ND-HowardGroup/pcr/README.md

ndPCR
=====

Historical code for ND PCR thermocycler, along with most current generation.
