ND-HowardGroup/pcr/doc/ND PCR - Device Documentation.docx

ND PCR – Device Documentation

Frank Kuhny

Howard Research Group

University of Notre Dame

Summer 2013

Overview

ND PCR is a device made by students in the Howard Research Group in the Electrical Engineering department at the University of Notre Dame. The goal of this device is to provide a field-portable means of amplifying DNA for any of a number of applications including testing for invasive species of aquatic animals in the Great Lakes waterways. The following report documents the current state of both the hardware and software that is being used to run ND PCR. It is intended as a reference to anyone who intends to begin work with any part of the device. The code referred to in Section 1 can be found in Appendix A of this document, and the schematics referred to in section two can be found in Appendix B of this document.

Section 1: Code

Declaration of variables/globals:

The beginning part of the code for ND PCR declares all of the variables and globals that are used throughout the program. This part of the code takes place from line 1 to line 123. The latter parts of the code are the functions used in the code as well as the operational part of the code.

Lines 1 through 26 are introductory comments to the program stating contributors to the code. A disclaimer also states that the program itself is software for free redistribution and modification.

Line 28 of the code begins the definition of the various libraries that will be used to run the thermocycler. Of particular interest is the PID library [1]. PID stands for proportional-integral-derivative. What this library does is calculates the output power required to heat the heater to the desired temperature setpoint as quickly as possible with minimal overshoot. The other libraries are the libraries to control the various components of the device such as the keypad and the display.

The code from lines 34 to 59 defines the keypad to have four rows and three columns. This part of the code also defines an object “keypad” with the class “Keypad” from the previous library definition [2]. When keypad is called later within the program it uses the input of the row and column to define the variable “keypad” to be one of the values ‘0’-‘9’, ‘*’, or “#” based on which key is pressed on the actual keypad. Also the definition of the pins the keypad will use on the microcontroller is here. The keypad uses pins 7-13.

After this, the variables for the PCR process are defined. These are the variables that change based on the specific recipe required for the primers that are being used. The variables ‘INITIALIZATION’, ‘DENATURATION’, etc. are the variables that will be used for the temperatures for the heating block for that specific step (the same step that the name denotes). Likewise, the variables ‘INIT_TIME’, ‘DENAT_TIME’, etc. are the variables to denote the amount of time the heating block will be held at the temperature for that step before moving on to the next step.

The next set of lines is the group of function prototypes that will be used at multiple points later in the code. These will be covered more extensively at a future point. Lines 98 to 114 initialize many variables that will be used throughout various functions. The number of cycles begins at zero and is incremented each cycle.

Lines 101 and 102 define the output pins for the heater and buzzer. In the code they are defined as 3 and 5, but there is an important distinction to be made here. These pin numbers do not refer to the pins on the microcontroller itself, but rather Digital Input/Output pin number that can be found on the microcontroller’s pinout diagram. The pin number for Digital I/O 3 is pin 1, and the pin number for Digital I/O 5 is pin 9. The pin to which the buzzer is connected is pin 26 on the microcontroller, but instead of using the pin number, ‘A3’ is written for the current setup as specified by the pinout diagram [3].

The final part before the setup() function defines the ‘myPID’ variable in the PID class. This is the code’s variable for changing the temperature based on the variables input, output and setpoint variables defined in line 117. Line 122 defines the myPID variable itself with the address operator (&) to the input, output, and setpoint variables. The numerical values in line 122 are the values for Kp, Ki, and Kd, respectively, which control the rise time, overshoot, settling time, and steady-state error of the PID controller [4].

Operating Procedure:

Lines 124 through 219 comprise the operating procedure for the code. This includes the setup() and loop() functions for the code. From within these functions, all the other functions of the code are called, and those will be described later. The setup() function gets the desired recipe from the user. The loop() function within the code repeats the procedure for the desired PCR recipe by using the PID function to change the temperature of the heating block as necessary.

The setup() function begins with line 124 of the code. This function begins serial communication at the specified frequency, here 9600 baud. Also, the pins for the heater and fan are set as output pins using the pinMode() function. The setup() function also calls the recipeChoice() function to determine which recipe preset will be used when running the PCR process. Using the selected recipe, the heater then brings the heating block to the selected “INITIALIZATION” temperature and delays the program until that temperature has been reached while outputting the “WAIT FOR HEATERS” message from line 139. Lines 143 to 150 are implemented to give the user time to put the vials into the PCR device; the LCD screen is cleared and outputs the given message and waits for the user. The output message says to press 1 to start the process, but the code allows for any button to be pressed to continue with the waitforkey() command. The final part of the setup() function prints the headers to the LCD screen as well as to the Serial monitor and turns on the PID.

The next function, which begins on line 166, is the loop() function which runs the PCR thermocycler itself following setup(). The arguments of the settemperature() function are first the temperature to which the heating block will be set followed by the amount of time it will be held at that temperature. First, the heating block is brought to the initialization temperature for the given amount of time as the beginning denaturation step. Then, the “for” loop beginning in line 173 runs the thermocycling itself based on the recipe. Line 179, the denaturation step, splits the DNA into single strands; line 180 bonds the primers for the DNA onto the single strands produced in the denaturation step; line 181 binds the complementary DNA onto the single strands in the extension step. For every iteration of the process, line 176 adds one to the current value of “i” until the program has gone through the correct number of cycles as specified by the recipe.

After all the cycles have been finished, the heating block is brought to the final elongation temperature for the given time in line 188. The final hold step (refrigeration) occurs in line 190. As soon as all the steps have finished, the code displays a message on the LCD screen to remove the vials and press a key to end. During this time, the buzzer is being sounded from line 200 until any key on the keypad is pressed. Realistically, the code from lines 193 to 204, the “remove vials” message as well as the buzzer sound, should be moved just after the final elongation step in line 188 for the device as the low final hold temperature cannot usually be reached with the current setup. This way, the user can remove the vials manually and refrigerate them in with some other means. Finally, in the current code, after the key has been pressed to end the buzzer, a final message loops indefinitely saying that the run has been completed and to refrigerate the vials.

Functions:

The final section of the code for ND PCR includes the rest of the functions used within the setup() and loop() functions. These functions are employed to control the temperature of the heating block and output data to the LCD display and serial output.

Following the thermocycling loop() function is the recipeChoice() function which begins on line 221. A simple message is output to the LCD display asking the user to choose a number one through three based on what recipe they desire. Currently recipes one and two could simulate realistic PCR processes although the recipes might need to be changed for slight temperature differences or slight differences in time for a certain step based on the specifications for the primers that are being used. Recipe number three exists as a test cycle that can be run through fully within a couple minutes rather than waiting for an entire PCR process to run which takes multiple hours. This allows for testing the heating block temperature for each step, the time on each step, and the overall number of cycles that were run for one process to ensure robustness of the code. After one of the buttons has been pressed to select a recipe, a confirmation message as to which recipe has been chosen is output to the LCD display.

The settemperature() function which begins on line 312 controls the heating block to the desired temperature when called. Lines 315 and 316 use the millis() function, which determines the time in milliseconds since the current program began running. The while loop which begins running in line 320 and ends in line 337 moves the heating block from the last step’s temperature to the current step’s temperature. It also outputs to the screen every second. Once the temperature for that step has been reached within one degree Fahrenheit, the program maintains that temperature for the desired time, “settime.” This time is added to the current time of the program which gives the value of “time2” in line 341, and the temperature is held until the new time is reached; then the function ends.

When the readTemps() function is called, the board takes a 5-bit value for the analog voltage read from each of the temperature sensors on the aluminum block, from pins 22 and 23 (A7 and A0 respectively for the Analog/Digital pin values). These values represent the voltage across the sensor to ground. Lines 371 takes the sensor value and calculates the resistance of the thermistor at that time given that the thermistor is part of a voltage divider. The value of the other resistor is known to be 10k Ohms, so the value of the thermistor can be calculated based on that and the value of the voltage across the thermistor. This value is then taken and put into line 372 which is the Beta equation for calculating the temperature of a thermistor:

The value 3560 is the Beta value for the specific thermistor being used [5], and the value for r∞ is a constant based on the Beta value from the following equation:

where R0 is the resistive value of the thermistor at room temperature. The final output is in Celsius, so 273.15 is subtracted from the temperature in Kelvin. The same process is used in lines 373 and 374 to determine the temperature of the other thermistor. To simplify the results that are achieved, the two temperatures are averaged to give the subsequent temperature of the heating block.

The third to last function of the program is the printData() function. The outputs to the LCD display are the time remaining as well as the current temperature of the heating block, separated by a space. The outputs to the serial display, as can be easily seen in the code, are the current step’s desired temperature (setTemp) followed by the two temperatures of the thermistors, the “Output” from the myPID variable, and finally the time remaining on the step.

The second to last function in the code is the controltemp() function. This is called from within the settemperature() function described above. The temperature of the heating block is read in line 418 from the previous readTemps() function, and the fan is either turned on from lines 422 to 426 if the temperature is too high, or is turned off if the temperature of the heating block is too low. Line 430 changes the new input to the myPID variable to the current temperature from the readTemps() function and the next increment in temperature is computed in line 433. The corresponding output in temperature is then sent to the heater pin in line 436 using analogWrite().

The final function of the code is the calcTimeRemaining() function which returns an integer guess as to how much time in minutes is remaining for the entire PCR process. The total time for all the steps (“totTime”) is computed in line 433 by adding the initialization step time to the final elongation time, the hold time, and the number of cycles multiplied by the quantity of the denaturation step time, the annealing step time, and the extension step time. Line 446 calculates the approximated time for the heating up and cooling down between steps to be about 0.07 times the total time for all the steps. This number is added, in line 449, to the “totTime” variable to give us the approximated time for the entire process including ramp up and down times in temperature, “totalTime.” The final line returns the value of the amount of time that has passed subtracted from the total time to give us the estimated amount of time remaining until the whole process has been completed.

Section 2: Schematics

The two boards that are currently being used to run ND PCR can be broken down into eight different sections by their various purposes. These sections are as follows: power supply, microcontroller, heater and serial output, LCD interface, temperature monitoring equipment, keypad, serial to USB converter, and buzzer alert. The first six were implemented on the parent board while the last two were added to the functionality of the overall device as a result of the daughter board. Each of these sections are described and discussed in greater detail in the following segments of this document.

Power Supply:

The power supply and voltage regulator for the ND PCR is depicted in Section A of Figure 1 in Appendix B. Part J2 in this section is the connector for the input power from the battery. The 12V from the power jack connects directly to the rest of the 12V wires on the board as well as connecting to the voltage regulator; any wire connecting to a voltage source with V+ has 12V on it. The voltage regulator can be seen as part IC2 on the schematic. This is a MC7805CT voltage regulator which takes the 12V from the power jack and steps it down to 5V. A schematic for the inner workings of the MC7805CT can be found on its data sheet and involves a complex network of over 20 transistors in order to make this step down in voltage. The output of the voltage regulator connects to all wires with a VCC denotation and thus has 5V on it relative to ground.

Microcontroller:

Section B of the parent board comprises the microcontroller and support components. Pin 29 connects to the reset button on the ICSP (in-circuit serial programmer) for when the chip needs to be reset when being programmed. Pins 4, 6, and 18 connect to the 5V from the voltage regulator to power the chip; pins 3, 5, and 21 connect to the ground pins on the chip. Across pins 7 and 8 is a 16 MHz crystal oscillator which is required for the clock of the microcontroller.

The microcontroller that is used is the ATMEGA328P with TQFP package.

Heater and Serial Output:

The connector pins denoted by JP5 in Section C of the parent board are for serial output communications. Also in this section are the two thermistors that are being used to heat the current heating block. They are NTC2K radial leaded thermistors. As stated in Section 1, they are connected into a voltage divider setup, and the voltage across each of them is read as a 5-bit value into the microcontroller to determine their temperatures to be heated or cooled appropriately. Finally, a battery check is in place to ensure power is coming from the battery. This connects the voltage across a 50k Ohm resistor to pin 19 on the microcontroller.

LCD Interface:

Section D of the parent board consists of a set of 12 pin headers, 5 of which connect to pins on the microcontroller. Pins 1 and 2 on the pin header are connections to 5V and ground, respectively. Pin 3 on the pin header is connected to a potentiometer. The main device that is connected to this pin header is the LCD display which uses three of the pins. A temporary buzzer is also connected to one of the pins for testing but will be implemented otherwise in the future.

Temperature Monitoring:

Section E consists of two sets of connectors to other components used in the PCR device. The JP4 connector pins are used for the heater to control the heating block. One of the pins is connected to 12V and the other is connected to the collector of the NPN transistor. This one, the TIP120, is a Darlington transistor which is a single device which has two cascaded NPN transistors sharing a common collector and with the emitter of one connected to the base of the other. The advantage of this device is that it allows for a much higher DC current gain than a single transistor could. For the TIP120, the current gain, also denoted by hFE, has a minimum value of 1000. The 500 ohm resistor connected to the base of the Darlington transistor ensures that the device operates in saturation. Similarly, JP1 is the set of connector pins to the fan. The fan is also connected on one side to the 12V power source but is instead connected to a PN2N2222A silicon transistor. This is only a single NPN transistor with minimum hFE values ranging from only 30-100. Likewise with this transistor, a resistor (this time 1K Ohm) is connected to the base to ensure the transistor operates in saturation when on. A capacitor is connected across both of these circuits, for the fan and heater controls, to provide positive feedback to them.

Keypad:

The final part of the parent board, Section F, contains the pin connectors for the keypad as well as pin connectors for the in-circuit serial programmer.

Serial to USB converter:

The daughter board consists of two sections itself. The first, Section G, is a USB to TTL serial converter. The chip that is used is the FT232RL chip. The setup and implementation for this circuit can be found on www.sparkfun.com/tutorials/108.

Buzzer alert:

Section H on the daughter board is the circuit for the buzzer as well as connector pins. The circuit for the buzzer is similar to the one for the fan on the parent board, having the pins across the buzzer connect to VCC and to the collector of the NPN transistor. This time though, a BC547 transistor is used as well as a 10k Ohm resistor going from the input pin to the base to ensure the device operates in saturation. The final set of connector pins has a pin for serial transmission, serial receiving, the buzzer input, VCC, and ground.

Section 3: Future Work

There are a few additional operations which ND PCR will hopefully be running by next summer. The first of these would be getting the serial communications to work so that data from the device can be sent to a computer. With the addition of the serial to USB converter this past summer, getting these communications running should require little, but still some, testing.

Another goal for ND PCR in the near future would be to get multiple wells working for the PCR process whereas only one well of the current heating block works successfully. There are likely two steps that need to be done so that this will work well. First the wells will likely need to be run separately instead of attempting to run three (or however man) on the same heating block. Dissipation of heat is not even across the current heating block. For multiple wells to work in the future, a more powerful microcontroller will need to be used to control separated single wells, but this will also require a redesign of the cooling/fan system in the current device.

The final goal for ND PCR in the near future is the joining of the device with the testing device used in the lab run by Dr. Hsueh-Chia Chang. With the uniting of the two devices, not only would DNA be amplified but it would also be tested for being of a specific type of animal all at once.

Appendix A

1. /* PersonalPCR, code for Arduino based PCR
2. Copyright (C) 2011 Chris Templeman <templemanautomation.com>
3. 2012 Scott Howard <showard@nd.edu>
5. Authors: Chris Templeman
6. Matt Brittan
7. Alex Toombs
8. Elizabeth Hunschke
9. Frank Kuhny
11. Date Last Modified: 5/19/13
13. This program is free software: you can redistribute it and/or modify
14. it under the terms of the GNU General Public License as published by
15. the Free Software Foundation, either version 3 of the License, or
16. (at your option) any later version.
18. This program is distributed in the hope that it will be useful,
19. but WITHOUT ANY WARRANTY; without even the implied warranty of
20. MERCHANTABILITY or FITNESS FOR A PARTICULAR PURPOSE. See the
21. GNU General Public License for more details.
23. You should have received a copy of the GNU General Public License
24. along with this program.
25. If not, see <http://www.gnu.org/licenses/>.
26. */
28. #include <PID_v1.h>
29. #include <math.h>
30. #include <SoftwareSerial.h>
31. #include <serLCD.h>
32. #include <Keypad.h>
34. //Four rows
35. const byte ROWS = 4;
36. //Three columns
37. const byte COLS = 3;
38. //Define the Keymap
39. char keys[ROWS][COLS] = {
40. {
41. '1','2','3' }
42. ,
43. {
44. '4','5','6' }
45. ,
46. {
47. '7','8','9' }
48. ,
49. {
50. '*','0','#' }
51. };
52. //connect to the row pinouts of the keypad
53. byte rowPins[ROWS] = {
54. 12, 7, 8, 10 };
55. //connect to the column pinouts of the keypad
56. byte colPins[COLS] = {
57. 11, 13, 9 };
59. Keypad keypad = Keypad( makeKeymap(keys), rowPins, colPins, ROWS, COLS );
61. // PCR Temperatures in C, to be set by recipe or user with keypad
62. // Presets set in recipeChoice function
63. double INITIALIZATION = 95;
64. double DENATURATION = 95;
65. double ANNEAL = 55;
66. double EXTENSION = 72;
67. double FINAL_ELONGATION = 72;
68. double HOLDT = 10;
70. // Number of cycles, input in recipeChoice
71. int NUMBER_OF_CYCLES = 35;
73. // PCR cycle times, corresponding to above double temps.
74. // Set in recipeChoice function.
75. double INIT_TIME = 30;
76. double DENAT_TIME = 30;
77. double ANNL_TIME = 60;
78. double EXT_TIME = 60;
79. double FIN_TIME = 300;
80. double HLD_TIME = 20;
82. // Definie the serial LCD object and communication pin
83. const int pin = 19;
84. serLCD lcd(pin);
86. // core function protoypes
87. // Directs user to select a recipe
88. void recipeChoice();
89. // Calls controltemp() to bring temp to a new level, hold it for a set time, calls printData() to display what is happening
90. void settemperature(double settemp, long settime);
91. // Prints data to LCD screen and serial monitor (time remaining in minutes, current temp)
92. void printData(double setTemp, int timer);
93. // Reads voltages from thermistor/resistor voltage dividers and calculates temperatures
94. void readTemps();
95. // Uses PID control with measurements from readTemps to set power to heater and fan
96. void controltemp(boolean fan_on, unsigned long timerinit, unsigned long timer, double settemp);
98. // track number of cycles
99. int cycle = 0; //"global" because used by serial print
101. // heater, fan, and buzzer pins
102. const int heater = 3;
103. const int fan = 5;
104. const int buzzer = A3;
106. // temperature for heater 1
107. double temp1 = 0;
108. // temperature for heater 2
109. double temp2 = 0;
110. // averaged temps
111. double temp = 0;
113. // will output every one sec
114. unsigned long pulse=0;
116. // Define PID variables we'll be connecting to
117. double Setpoint, Input, Output;
119. //Specify the links and initial tuning parameters, also do so in
120. //loop() with SetTunings
121. // tunings are setup and material specific
122. PID myPID(&Input, &Output, &Setpoint,33.01,0.35,120.55, DIRECT);
124. // Set up variables, recipe choice, and headers
125. void setup()
126. {
127. // Begin serial communication at 9600 baud
128. Serial.begin(9600);
129. // set output pins to output
130. pinMode(heater, OUTPUT);
131. pinMode(fan, OUTPUT);
133. // Get recipe to control cycle
134. recipeChoice();
136. // print delay message until heaters are at INITIALIZATION point
137. while(temp > INITIALIZATION) {
138. lcd.selectLine(1);
139. lcd.print("WAIT FOR HEATERS");
140. }
142. // after heats are heated, wait for input before starting recipe
143. lcd.clear();
144. lcd.selectLine(1);
145. lcd.print("Load vials");
146. lcd.selectLine(2);
147. lcd.print("Hit 1 to start");
149. // wait until any key is pressed.
150. keypad.waitForKey();
152. // Print headers on LCD
153. lcd.clear();
154. lcd.print("min_left T");
155. lcd.selectLine(2);
157. // Print to Serial Monitor on Laptop
158. Serial.print(" s cyc sp T1 T2 output time_rem");
160. //turn the PID on
161. myPID.SetMode(AUTOMATIC);
163. }
165. // Doesn't actually loop like it's supposed to. This will only loop once, in theory
166. void loop()
167. {
168. // Set the temperature to remain at INITIALIZATION for INIT_TIME seconds
169. settemperature(INITIALIZATION, INIT_TIME);
171. // Loop for PCR recipe while current cycles is less than total number of cycles, as specified in recipe
172. // Real loop is here!
173. for (int i = 0; i < NUMBER_OF_CYCLES; i++)
174. {
175. // increment cycle
176. cycle++;
178. // step through each step of process
179. settemperature(DENATURATION, DENAT_TIME);
180. settemperature(ANNEAL, ANNL_TIME);
181. settemperature(EXTENSION, EXT_TIME);
182. }
183. cycle++;
185. // PCR process loop ended; elongating, holding, then buzzing
187. // Final
188. settemperature(FINAL_ELONGATION, FIN_TIME);
189. // Hold at HOLD_TEMPERATURE for a long time
190. settemperature(HOLDT, HLD_TIME);
192. // Play buzzer until button hit, as PCR is done, tubes should be removed
193. lcd.clear();
194. lcd.selectLine(1);
195. lcd.print("REMOVE VIALS!");
196. lcd.selectLine(2);
197. lcd.print("Hit Key For End");
199. // play annoying buzzer until they hit a key to alert for vial removal
200. digitalWrite(buzzer, HIGH);
202. // buzzer should play until a key is pressed
203. keypad.waitForKey();
204. digitalWrite(buzzer, LOW);
206. lcd.clear();
208. // display end message, loop infinitely
209. while(1) {
210. lcd.selectLine(1);
211. lcd.print("Fridge vials!");
212. lcd.selectLine(2);
213. lcd.print("Run complete.");
215. // delay to prevent flicker
216. delay(500);
217. }
218. }
220. // Either choose a preset recipe for temperatures
221. void recipeChoice() {
222. // Clear LCD, select line 1
223. lcd.clear();
224. lcd.selectLine(1);
226. // Welcome message displayed
227. delay(1000);
228. lcd.print("Welcome to NDPCR");
229. delay(2000);
230. lcd.clear();
231. lcd.clear();
233. lcd.selectLine(1);
234. lcd.print("Enter choice:");
235. lcd.selectLine(2);
236. lcd.print("(1 thru 3)");
238. // Recipe choice input (char digit)
239. char c2 = keypad.waitForKey();
241. // Sets recipes, can be 0-9, # and * as chars (up to 12 recipes stored)
242. if(c2 == '1') {
243. // Edit these fields to change recipe
244. INITIALIZATION = 95;
245. DENATURATION = 95;
246. ANNEAL = 55;
247. EXTENSION = 72;
248. FINAL_ELONGATION = 72;
249. HOLDT = 10;
250. NUMBER_OF_CYCLES = 35;
252. // Change timing, set in seconds
253. INIT_TIME = 30;
254. DENAT_TIME = 30;
255. ANNL_TIME = 60;
256. EXT_TIME = 60;
257. FIN_TIME = 300;
258. HLD_TIME = 20;
260. lcd.clear();
261. lcd.print("Rcp 1 Chosen");
262. delay(500);
263. }
264. else if(c2 == '2') {
265. // Edit these fields to change recipe
266. INITIALIZATION = 90;
267. DENATURATION = 96;
268. ANNEAL = 50;
269. EXTENSION = 74;
270. FINAL_ELONGATION = 73;
271. HOLDT = 12;
272. NUMBER_OF_CYCLES = 20;
274. // Change timing, set in seconds
275. INIT_TIME = 30;
276. DENAT_TIME = 30;
277. ANNL_TIME = 60;
278. EXT_TIME = 60;
279. FIN_TIME = 300;
280. HLD_TIME = 20;
282. lcd.clear();
283. lcd.print("Rcp 2 Chosen");
284. delay(500);
285. }
286. else if(c2 == '3') {
287. // Edit these fields to change recipe
288. // This recipe currently used to test lcd display
289. INITIALIZATION = 35;
290. DENATURATION = 30;
291. ANNEAL = 25;
292. EXTENSION = 27;
293. FINAL_ELONGATION = 27;
294. HOLDT = 23;
295. NUMBER_OF_CYCLES = 3;
297. // Change timing, set in seconds
298. INIT_TIME = 10;
299. DENAT_TIME = 10;
300. ANNL_TIME = 10;
301. EXT_TIME = 5;
302. FIN_TIME = 5;
303. HLD_TIME = 5;
305. lcd.clear();
306. lcd.print("Test RCP!");
307. delay(500);
308. }
309. }
311. // Set temperature of heaters
312. void settemperature(double settemp, long settime)
313. {
314. unsigned long timer, time2, timerinit;
315. timer = millis();
316. timerinit=timer;
317. Setpoint = settemp;
319. // while temperature is off from settemp, keep looping
320. while (abs(temp-settemp) > 1.0)
321. {
322. // control PID and fan with other function
323. controltemp(1, timerinit, timer, settemp);
325. // get current time in ms
326. timer=millis();
328. // print to screen every second
329. if(timer>pulse)
330. {
331. // increment by 1 second
332. pulse+=1000;
334. // output to screen
335. printData(settemp, 0);
336. }
337. }
339. // Grabs time to control step duration
340. timerinit=timer;
341. time2=settime*1000+timerinit;
343. // Hold at temperature while at current step
344. while (timer < time2)
345. {
346. // control PID output and fan on/off by using controltemp function
347. controltemp(1, timerinit, timer, settemp);
349. // Every second, output to screen
350. timer=millis();
351. if(timer>pulse)
352. {
353. pulse+=1000;
354. // print data to LCD/serial monitor
355. printData(settemp, (timer-timerinit)/1000.0);
356. }
357. }
358. }
360. // read temperatures from digital temperature sensors on aluminum block
361. void readTemps()
362. {
363. double r1, r2;
364. int sensorValue1, sensorValue2;
365. //read all three sensors
366. sensorValue1 = analogRead(A0);
367. delay(1); //delay to prevent excess ringing, from datasheet
368. sensorValue2 = analogRead(A7);
370. //convert all thermistors from "counts" voltage to C
371. r1 = 1000.0/((1023.0/sensorValue1) - 1);
372. temp1 = 3560.0/log(r1/0.0130444106) - 273.15;
373. r2 = 1000.0/((1023.0/sensorValue2) - 1);
374. temp2 = 3560.0/log(r2/0.0130444106) - 273.15;
376. // Average temperatures of two sensors to control fan and PID
377. temp = (temp1 + temp2) / 2;
378. }
381. // displays data to LCD monitor and serial monitor
382. void printData(double setTemp, int timer)
383. {
384. char buff[17];
386. // buffered charString that contains data printed to LCD
387. sprintf(buff, "%3.d ", calcTimeRemaining());
389. // Prints out time remaining in minutes and current averaged temp (always on line 2)
390. lcd.selectLine(2);
391. lcd.print(buff);
392. lcd.print(" ");
393. lcd.print(temp);
395. // Print to serial monitor as well
396. // Appearance: ## ##.## ##.## ##.##
397. Serial.println();
398. Serial.println();
399. Serial.print(buff);
400. Serial.print(" ");
401. Serial.print(int(setTemp));
403. Serial.print(" ");
405. Serial.print(temp1);
406. Serial.print(" ");
407. Serial.print(temp2);
408. Serial.print(" ");
409. Serial.print(Output);
410. Serial.print(" ");
411. Serial.print(calcTimeRemaining());
412. }
414. // Control temperature by calculating PID and turning fan on or off.
415. void controltemp(boolean fan_on, unsigned long timerinit, unsigned long timer, double settemp)
416. {
417. // Read temperatures into global variables
418. readTemps();
420. // if temp too high, turn fan on to cool. else, turn fan off.
421. // NOTE: fan_on is a stupid variable that is always 1 when this function is called
422. if (fan_on && temp>settemp+1)
423. {
424. // turn fan on
425. digitalWrite(fan, HIGH);
426. }
427. else digitalWrite(fan, LOW);
429. // Send temperature to PID controller for predictive contrl
430. Input = temp;
432. // Compute next PID step
433. myPID.Compute();
435. // Control heater based upon PID compute
436. analogWrite(heater, Output);
437. }
439. // return time remaining on this PCR recipe
440. // return: time remaining in minutes, int
441. int calcTimeRemaining() {
442. // total process time in seconds, excluding ramp times
443. int totTime = INIT_TIME + (NUMBER_OF_CYCLES * (DENAT_TIME + ANNL_TIME + EXT_TIME)) + (FIN_TIME + HLD_TIME);
445. // "fudge factor" for ramp times, etc.; needs to be more elegant later
446. int fudgeFactor = totTime*.07;
448. // Calculate final time
449. int totalTime = totTime + fudgeFactor;
451. // returns time remaining in minutes as an integer
452. return (totalTime - (millis()/1000))/60;
453. }

Appendix B

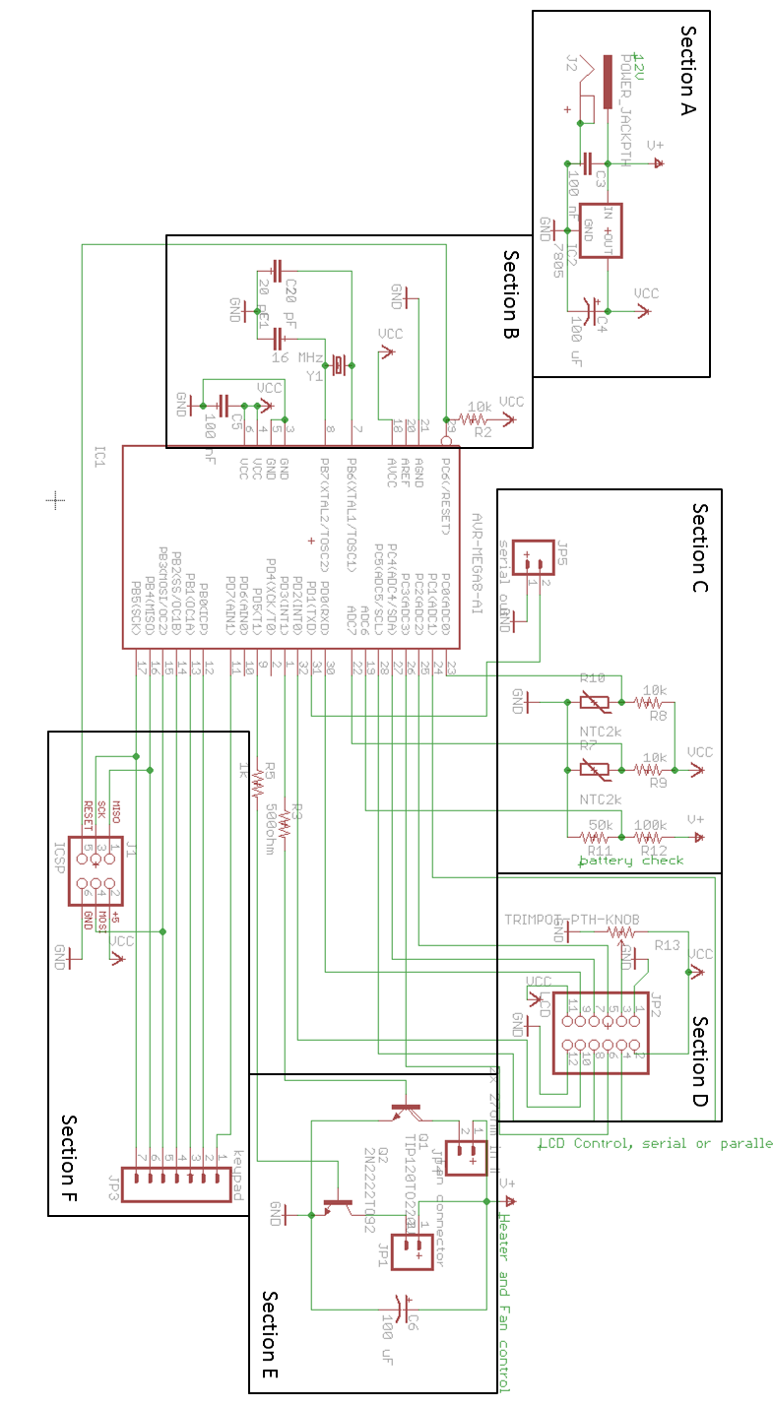
[picture p1: figure]

Figure 1. Schematic for Parent Board

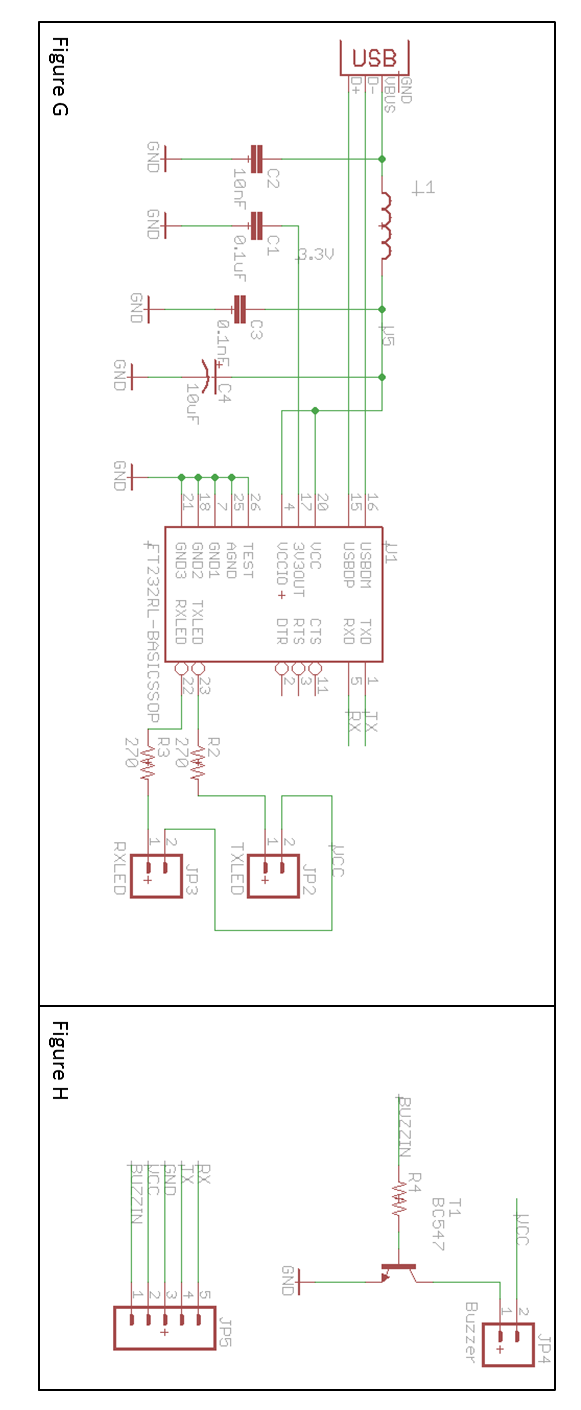
[picture p2: figure]

Figure 2. Schematic for Daughter Board

Works Cited

[1] https://github.com/br3ttb/Arduino-PID-Library/blob/master/PID_v1/PID_v1.h

[2] http://playground.arduino.cc/Code/Keypad#CurrentVersion

[3] http://www.hobbytronics.co.uk/arduino-atmega328-pinout

[4] http://wwwdsa.uqac.ca/~rbeguena/Systemes_Asservis/PID.pdf

[5] http://www.epcos.com/inf/50/db/ntc_09/MiniSensors__B57861__S861.pdf
