ND-HowardGroup/pcr/doc/PCR_basics.pdf

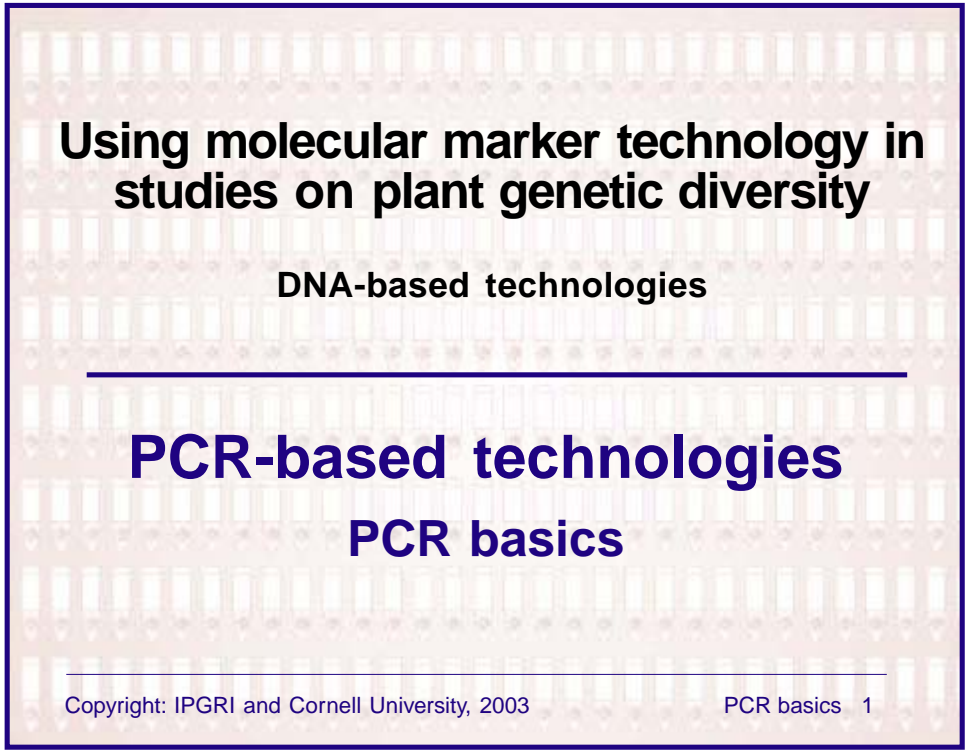
[picture p3: figure]
Using molecular marker technology in studies on plant genetic diversity; DNA-based technologies; PCR-based technologies PCR basics

Copyright: IPGRI and Cornell University, 2003 | PCR basics 1

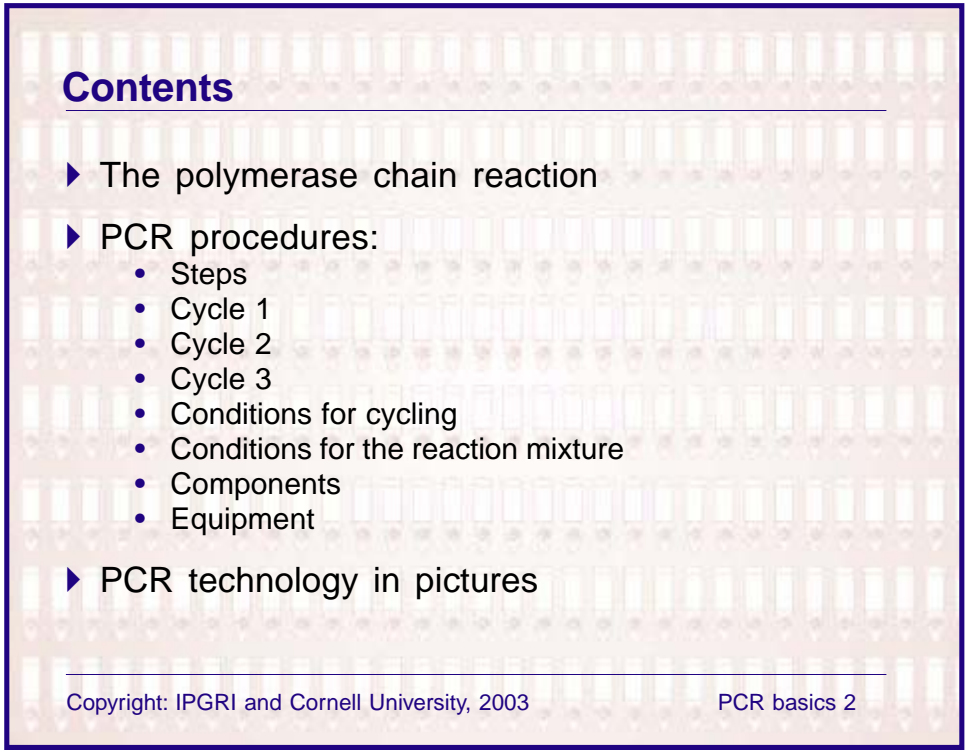
[picture p4: figure]
Contents; ! The polymerase chain reaction; ! PCR procedures: • Steps; • Cycle 1 • Cycle 2 • Cycle 3 • Conditions for cycling • Conditions for the reaction mixture • Components • Equipment ! PCR technology in pictures

2

Copyright: IPGRI and Cornell University, 2003 | PCR basics 2

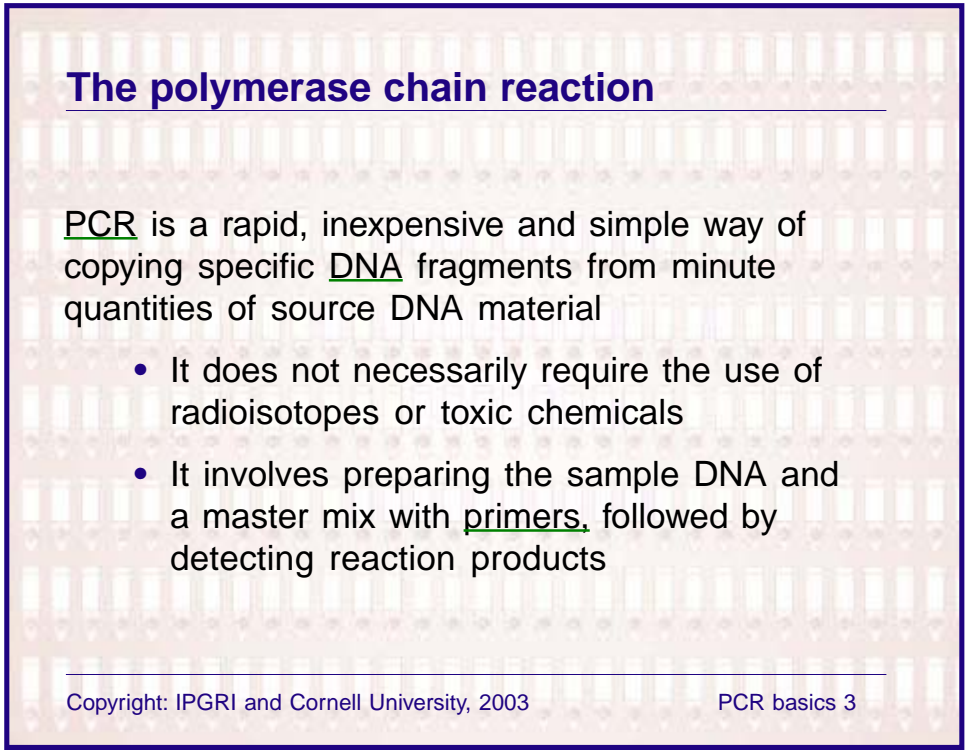
[picture p5: figure]
quantities of source DNA material; radioisotopes or toxic chemicals; a master mix with primers, followed by detecting reaction products; The polymerase chain reaction

3

Copyright: IPGRI and Cornell University, 2003 | PCR basics 3

## PCR is a rapid, inexpensive and simple way of copying specific DNA fragments from minute

## - It does not necessarily require the use of

## - It involves preparing the sample DNA and

The polymerase chain reaction (PCR; Erlich, 1989) is a powerful technique that has rapidly become one of the most widely used techniques in molecular biology because it is quick, inexpensive and simple. The technique amplifies specific DNA fragments from minute quantities of source DNA material, even when that source DNA is of relatively poor quality.

Reference

Erlich, H.A. 1989. PCR technology: principles and applications for DNA amplifications. Stockton Press, NY.

4

Copyright: IPGRI and Cornell University, 2003 | PCR basics 4

## PCR procedures: steps

The DNA polymerase, known as 'Taq polymerase', is named after the hot-spring bacterium Thermus aquaticus from which it was originally isolated. The enzyme can withstand the high temperatures needed for DNA-strand separation, and can be left in the reaction tube.

The cycle of heating and cooling is repeated over and over, stimulating the primers to bind to the original sequences and to newly synthesised sequences. The enzyme will again extend primer sequences. This cycling of temperatures results in copying and then copying of copies, and so on, leading to an exponential increase in the number of copies of specific sequences. Because the amount of DNA placed in the tube at the beginning is very small, almost all the DNA at the end of the reaction cycles is copied sequences.

The reaction products are separated by gel electrophoresis. Depending on the quantity produced and the size of the amplified fragment, the reaction products can be visualised directly by staining with ethidium bromide or a silver-staining protocol, or by means of radioisotopes and autoradiography.

## ! Denaturation: DNA fragments are heated at high temperatures, which reduce the DNA double helix to single strands. These strands become accessible to primers

! Annealing: The reaction mixture is cooled down.

## Primers anneal to the complementary regions in the DNA template strands, and double strands are formed again between primers and complementary sequences

## ! Extension: The DNA polymerase synthesises a complementary strand. The enzyme reads the opposing strand sequence and extends the primers by adding nucleotides in the order in which they can pair. The whole process is repeated over and over

5

Copyright: IPGRI and Cornell University, 2003 | PCR basics 5

## PCR procedures: cycle 1

The PCR steps are all carried out, one after the other, in bouts of cycling. Cycle 1 is as follows:

- During denaturation (about 1 min at 95°C), the DNA strands separate to form single strands.
- During annealing (about 1 min at temperatures ranging between 45°C and 60°C), one primer binds to one DNA strand and another binds to the complementary strand. The annealing sites of the primers are chosen so that they will prime DNA synthesis in the region of interest during extension.
- During extension (about 1 min at 72°C), the DNA synthesis proceeds through the target region and for variable distances into the flanking region, giving rise to 'long fragments' of variable lengths

Double-stranded template DNA

5´ | 3´
3´ | 5´

Denaturing

Annealing

Extension

Primer 2 | Primer 1
5´ | 3´
5´ | 3´
3´ | 5´
3´ | 5´
3´ | 5´
5´ | 3´ Primer recognition site

Primer
recognition site

Adapted from Griffiths et al. 1996

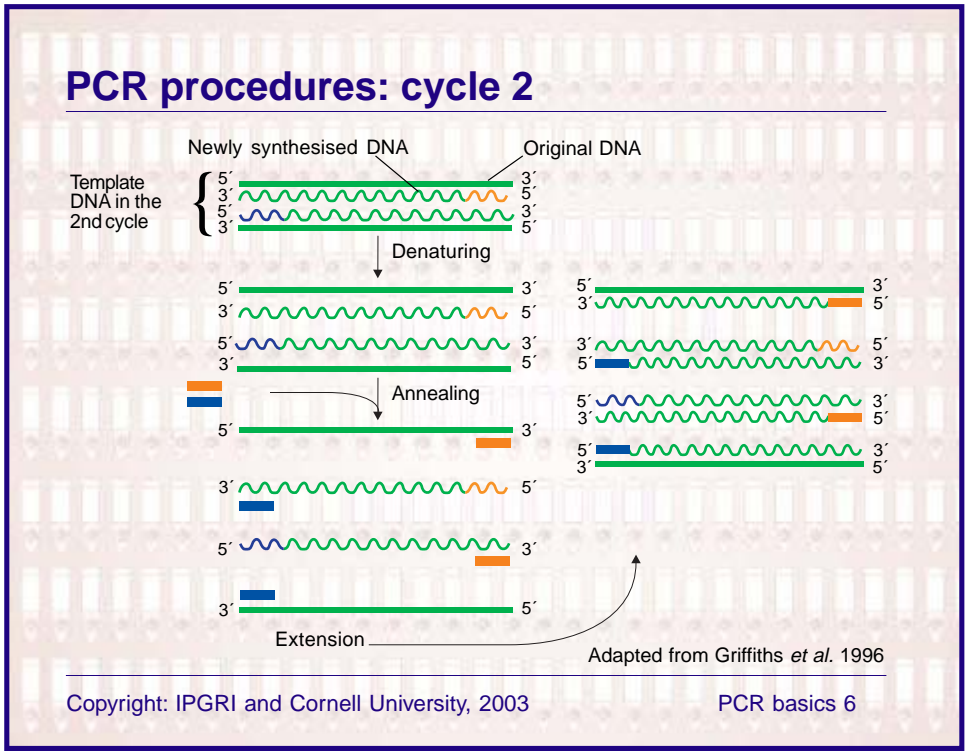
[picture p6: figure]
PCR procedures: cycle 2; Adapted from Griffiths et al. 1996; Denaturing; Annealing; Extension; Newly synthesised DNA; Template DNA in the 2nd cycle; Original DNA

6

Copyright: IPGRI and Cornell University, 2003 | PCR basics 6

When the second cycle starts, there are effectively two types of template: (1) the original DNA strands; and (2) the newly synthesised DNA strands, consisting of the target region and variable lengths of the flanking region at the 3' end. When the latter template is used in this cycle, only the target region is replicated.

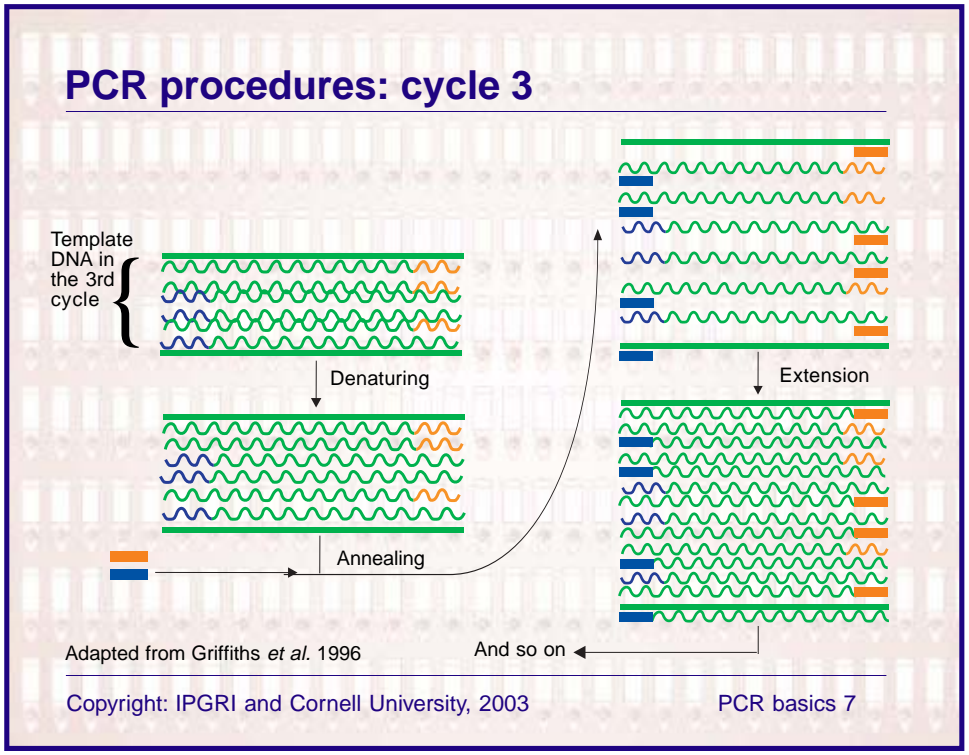
[picture p7: figure]
PCR procedures: cycle 3; Template DNA in the 3rd cycle; And so on; Denaturing; Annealing; Extension; Adapted from Griffiths et al. 1996

7

Copyright: IPGRI and Cornell University, 2003 | PCR basics 7

In the third cycle, the newly synthesised target region DNA (i.e. without flanking regions) acts as template. The original DNA molecule is still present, and will be until the end of the reaction. However, after a few cycles, the newly synthesised DNA fragment quickly establishes itself as the predominant template.

Cycles are typically repeated 25 to 45 times. Standardisation of the thermocycler's running conditions is essential for the reproducibility of results.

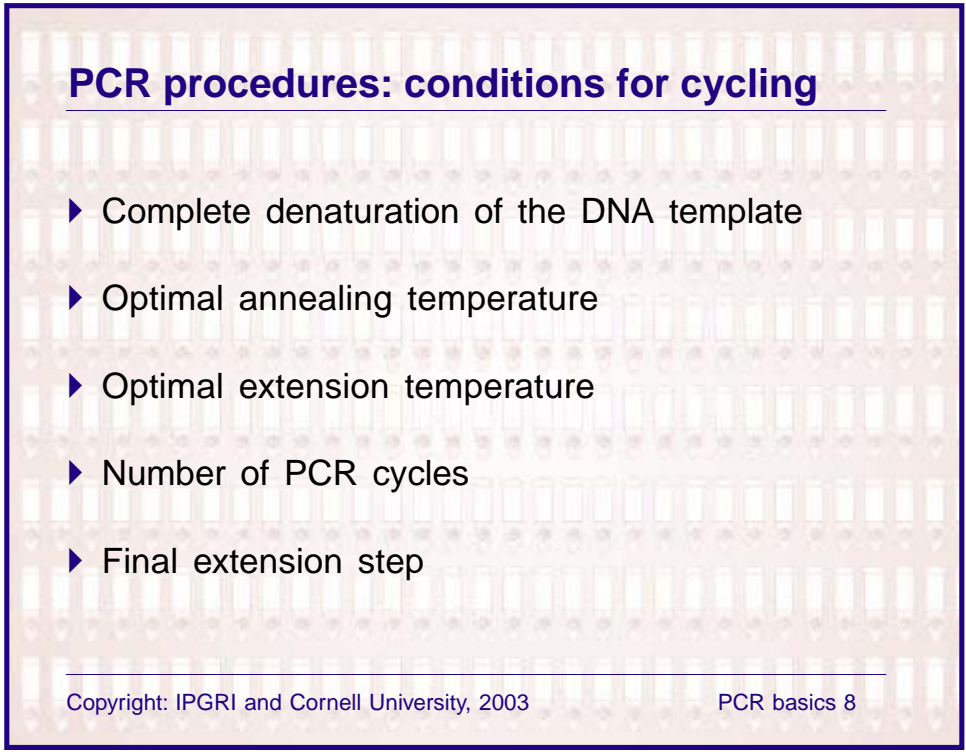
[picture p8: figure]
PCR procedures: conditions for cycling; ! Optimal annealing temperature; ! Optimal extension temperature; ! Number of PCR cycles; ! Final extension step

8

Copyright: IPGRI and Cornell University, 2003 | PCR basics 8

## ! Complete denaturation of the DNA template

In the initial denaturation step, complete denaturation of the DNA template at the start of the PCR reaction is essential. Incomplete denaturation of DNA will result in the inefficient use of the template in the first amplification cycle and, consequently, poor yield of PCR product.

The annealing temperature may be estimated as 5°C lower than the melting temperature of the primer-template DNA duplex. If non-specific PCR products are obtained in addition to the expected product, the annealing temperature can be optimised by increasing it stepwise by 1-2°C.

Usually, the extension step is performed at 72°C and a 1-min extension is sufficient to synthesise PCR fragments as long as 2 kb (kb = kilobase = 1000 bp). When larger DNA fragments are amplified, time is usually extended by 1 min per 1000 bp.

The number of PCR cycles will basically depend on the expected yield of the PCR product.

After the last cycle, samples are usually incubated at 72°C for 5 min to fill in the protruding ends of newly synthesised PCR products.

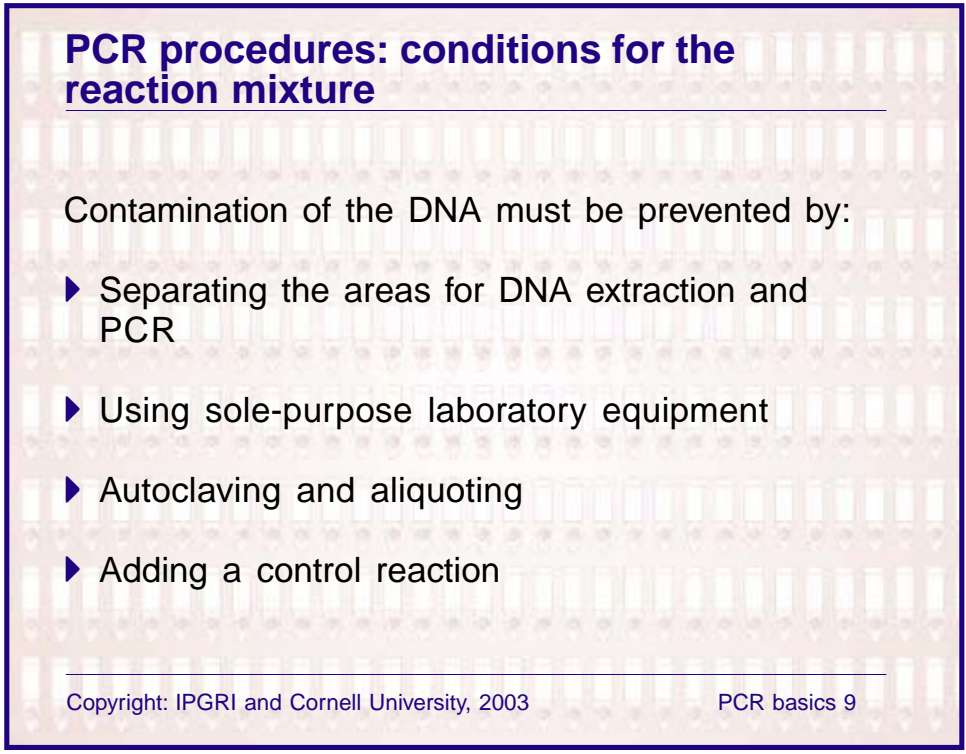
[picture p9: figure]
PCR procedures: conditions for the reaction mixture; PCR; ! Autoclaving and aliquoting; ! Adding a control reaction

9

Copyright: IPGRI and Cornell University, 2003 | PCR basics 9

## Contamination of the DNA must be prevented by:

## ! Separating the areas for DNA extraction and

## ! Using sole-purpose laboratory equipment

Some useful tips:

- DNA extraction and PCR reaction mixing and processing should be performed in separate areas.
- Use of sole-purpose vessels and positive displacement pipettes or tips for DNA sample and reaction mixture preparation is strongly recommended.
- All solutions, except dNTPs, primers and Taq DNA polymerase, should be autoclaved. Where possible, solutions should be aliquoted in small quantities and stored in designated PCR areas.
- A good practice, to confirm absence of contamination, is to add a control reaction without template DNA.

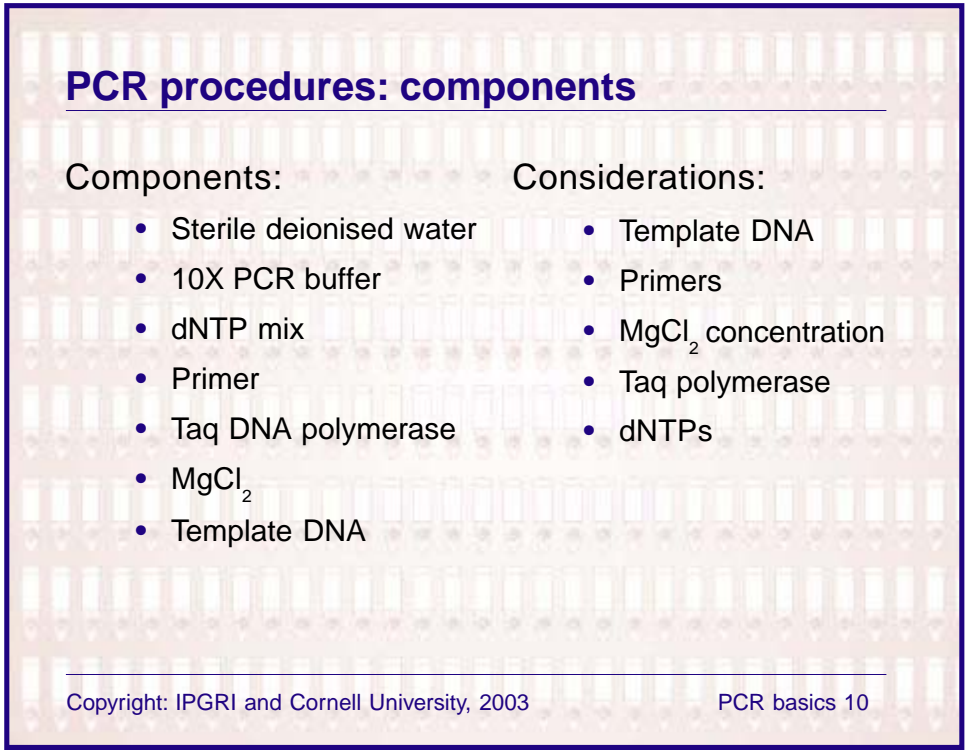
[picture p10: figure]
PCR procedures: components; Components:; • Sterile deionised water • 10X PCR buffer • dNTP mix • Primer • Taq DNA polymerase • MgCl2 • Template DNA; Considerations:; • Template DNA • Primers • MgCl2; concentration • Taq polymerase • dNTPs

10

Copyright: IPGRI and Cornell University, 2003 | PCR basics 10

Many PCR machines are now available in 48-, 96- or 384-well formats. This, combined with the use of multichannel pipettors, can greatly increase the number of reactions that can be done simultaneously. If several reactions need to be simultaneously prepared, a master mix should be used as follows: water, buffer, dNTPs, primers, MgCl2 and Taq DNA polymerase in a single tube. This will then be aliquoted into individual tubes. Considerations:

Template DNA. Nearly any standard method is suitable for template DNA purification. An adequate amount of template DNA is between 0.1 and 1 µg for genomic DNA for a total reaction mixture of 100 µl. Larger template DNA amounts usually increase the yield of non-specific PCR products.

Primers. (1) PCR primers should be 10-24 nucleotides in length. (2) The GC content should be 40%-60%. (3) The primer should not be self-complementary or complementary to any other primer in the reaction mixture, to prevent primer-dimer and hairpin formation.
(4) Melting temperatures of primer pairs should not differ by more than 5°C, so that the GC content and length must be chosen accordingly. (5) The melting and annealing temperatures of a primer are estimated as follows: if the primer is shorter than 25 nucleotides, the approximate melting temperature is calculated with the formula: Tm = 4 (G + C) + 2 (A + T). (6) The annealing temperature should be about 5°C lower than the melting temperature.
MgCl2 concentration. Because Mg2
+ ions form complexes with dNTPs, primers and DNA templates, the optimal concentration of MgCl2 has to be selected for each experiment. Too few Mg2
+ ions result in a low yield of PCR product, and too many will increase the yield of non-specific products. The recommended range of MgCl2 concentration is 1 to 3 mM, under the standard reaction conditions specified.

Taq DNA polymerase. Higher Taq DNA polymerase concentrations than needed may cause synthesis of non-specific products.

dNTPs. The concentration of each dNTP (dATP, dCTP, dGTP, dTTP) in the reaction mixture is usually 200 µM. These concentrations must be checked as being equal, because inaccuracies will increase the degree of misincorporation.

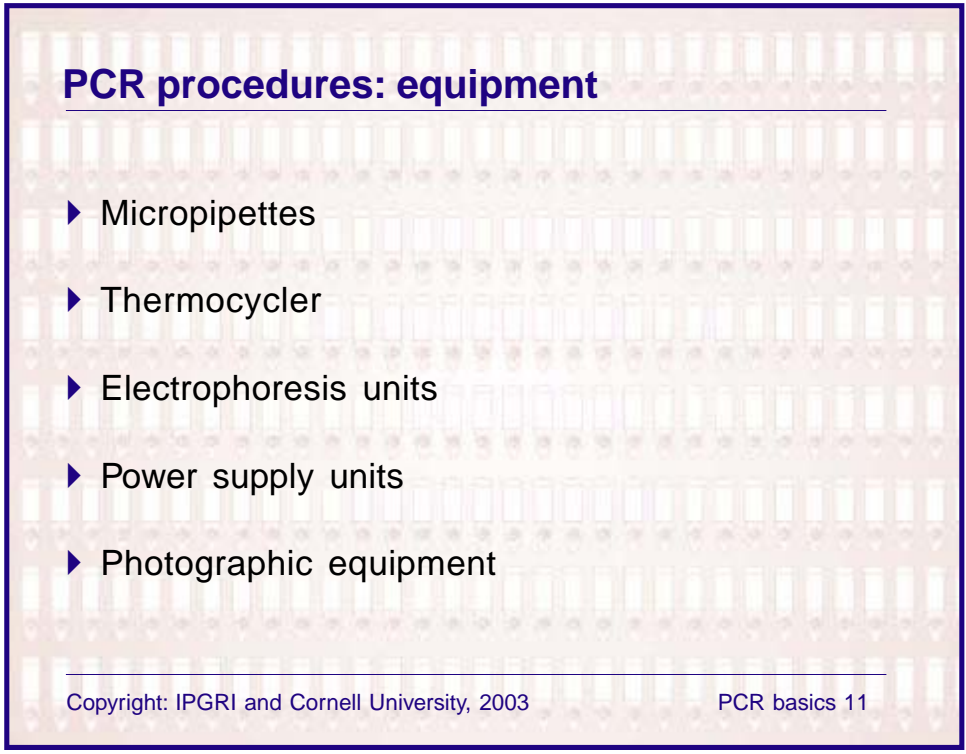
[picture p11: figure]
PCR procedures: equipment; ! Micropipettes; ! Thermocycler; ! Electrophoresis units; ! Power supply units; ! Photographic equipment

11

Copyright: IPGRI and Cornell University, 2003 | PCR basics 11

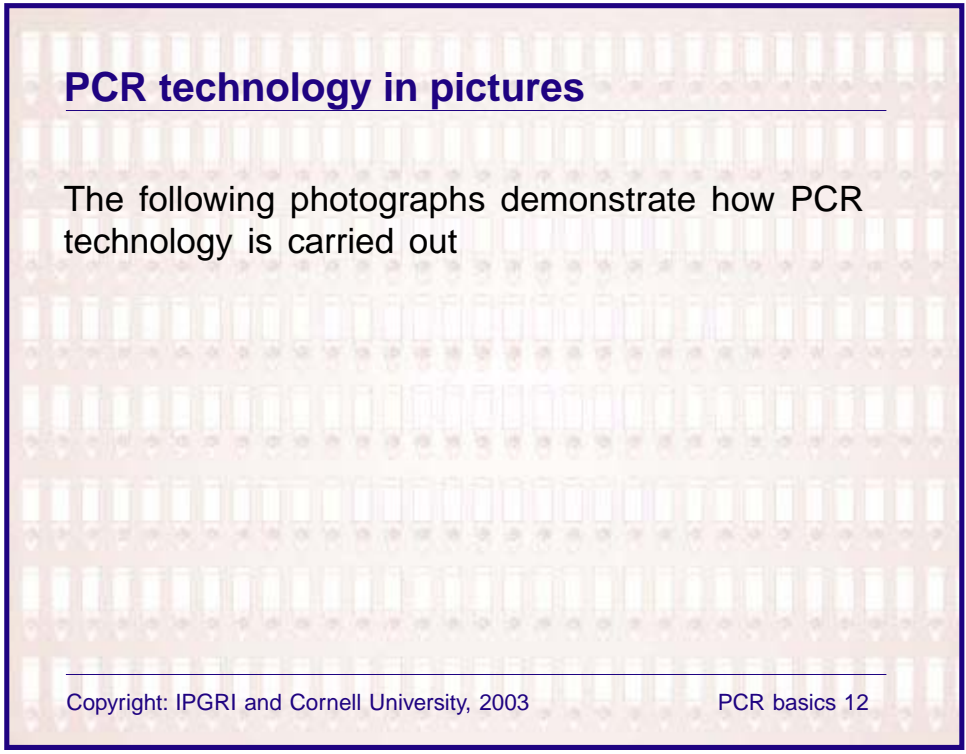
[picture p12: figure]
PCR technology in pictures; technology is carried out

12

Copyright: IPGRI and Cornell University, 2003 | PCR basics 12

## The following photographs demonstrate how PCR

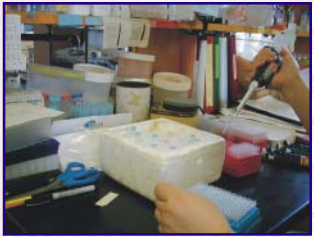
[picture p13: figure]

13

Copyright: IPGRI and Cornell University, 2003 | PCR basics 13

The PCR mixture is prepared on ice. Safety clothing is not required, but may benefit the reaction unless good sterile techniques are practised.

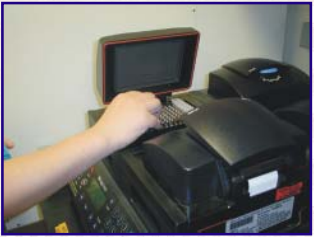
[picture p14: figure]

14

Copyright: IPGRI and Cornell University, 2003 | PCR basics 14

The PCR reactions are loaded into the thermocycler.

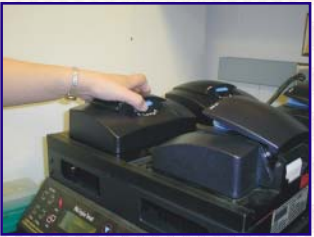
[picture p15: figure]

15

Copyright: IPGRI and Cornell University, 2003 | PCR basics 15

The thermocycler is locked shut and programmed.

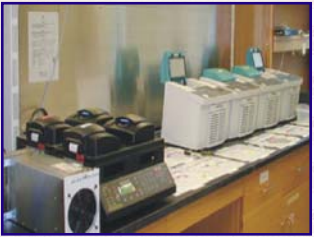
[picture p16: figure]

16

Copyright: IPGRI and Cornell University, 2003 | PCR basics 16

Different types of thermocyclers exist: the black one is a tetrad, in which 4 sets of 96 samples can be run simultaneously. The four smaller white ones each have a 96-well capacity.

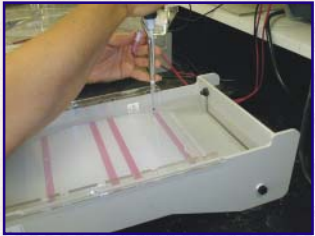
[picture p17: figure]

17

Copyright: IPGRI and Cornell University, 2003 | PCR basics 17

Depending on the size of the PCR bands produced and the discrimination needed, band visualisation can be accomplished through either a regular, horizontal, agarose gel or a vertical acrylamide sequencing gel (see next slide). Here, the products are being run on an agarose gel.

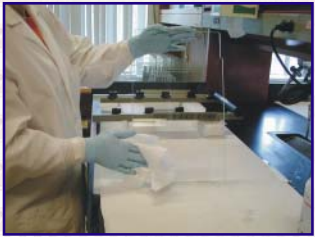
[picture p18: figure]

18

Copyright: IPGRI and Cornell University, 2003 | PCR basics 18

The acrylamide gel may be run in either an independent unit or an automatic sequencer. The preparation of the sequencing gel, although somewhat complicated to set up, is similar for both cases. Here, the glass is being cleaned and wiped before preparing the gel for an automatic sequencer.

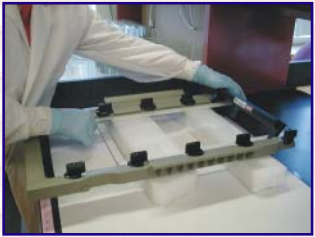
[picture p19: figure]

19

Copyright: IPGRI and Cornell University, 2003 | PCR basics 19

Glass units are being inserted into the frame, which will be fitted into the sequencer.

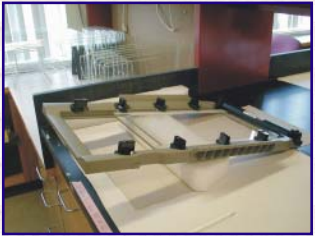
[picture p20: figure]

20

Copyright: IPGRI and Cornell University, 2003 | PCR basics 20

The glass units are clamped into place, and the entire unit readied for gel to be poured in.

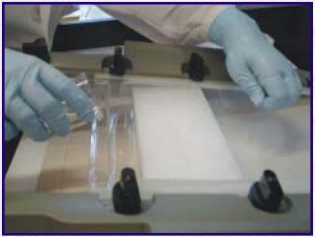
[picture p21: figure]

21

Copyright: IPGRI and Cornell University, 2003 | PCR basics 21

Liquid acrylamide gel is poured into the mould. Because acrylamide is a carcinogen, safety clothing must be worn.

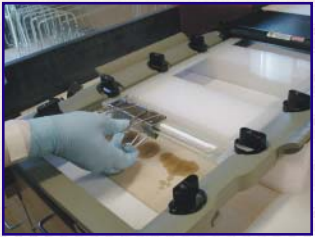
[picture p22: figure]

22

Copyright: IPGRI and Cornell University, 2003 | PCR basics 22

Clamps grip the bottom ends of the glass units to prevent the gel leaking.

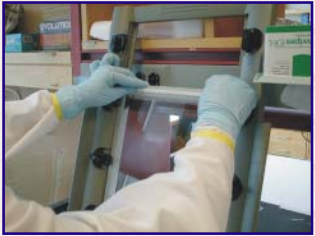
[picture p23: figure]

23

Copyright: IPGRI and Cornell University, 2003 | PCR basics 23

A comb is inserted into the top of the gel to create the wells into which the samples will be loaded.

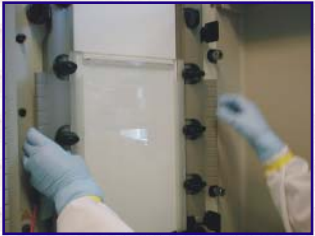
[picture p24: figure]

24

Copyright: IPGRI and Cornell University, 2003 | PCR basics 24

Once the gel is set, the unit is placed into the sequencing machine.

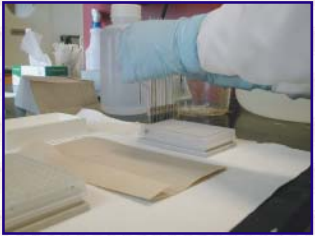
[picture p25: figure]

25

Copyright: IPGRI and Cornell University, 2003 | PCR basics 25

Samples are taken up with a multi-pipettor …

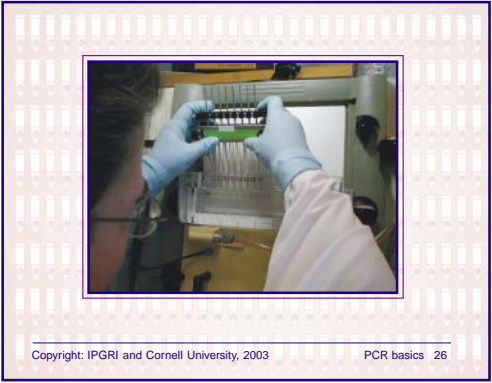
[picture p26: figure]

26

Copyright: IPGRI and Cornell University, 2003 | PCR basics 26

…and loaded into the wells of the gel.

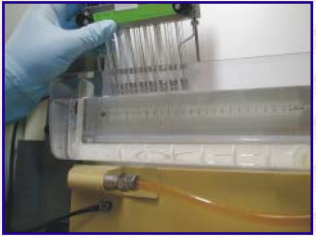
[picture p27: figure]

27

Copyright: IPGRI and Cornell University, 2003 | PCR basics 27

This is a close-up from the previous photograph. Note the extremely small size of the wells and the pipettor, making it possible to load large numbers of samples into each gel.

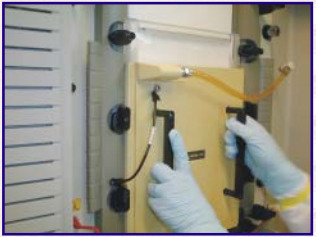
[picture p28: figure]

28

Copyright: IPGRI and Cornell University, 2003 | PCR basics 28

A heating plate is placed against the gel to ensure a constant performing temperature.

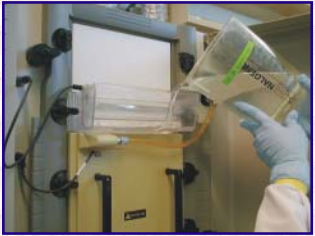
[picture p29: figure]

29

Copyright: IPGRI and Cornell University, 2003 | PCR basics 29

Gel buffer is loaded into the top tank…

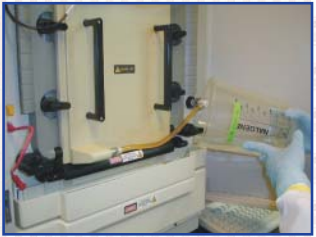
[picture p30: figure]

30

Copyright: IPGRI and Cornell University, 2003 | PCR basics 30

…and into the bottom tank.

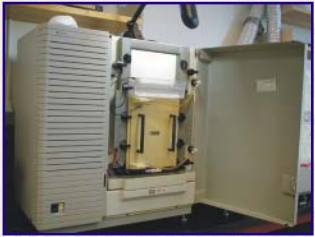
[picture p31: figure]

31

Copyright: IPGRI and Cornell University, 2003 | PCR basics 31

A final look, then the door is shut and the program begun.

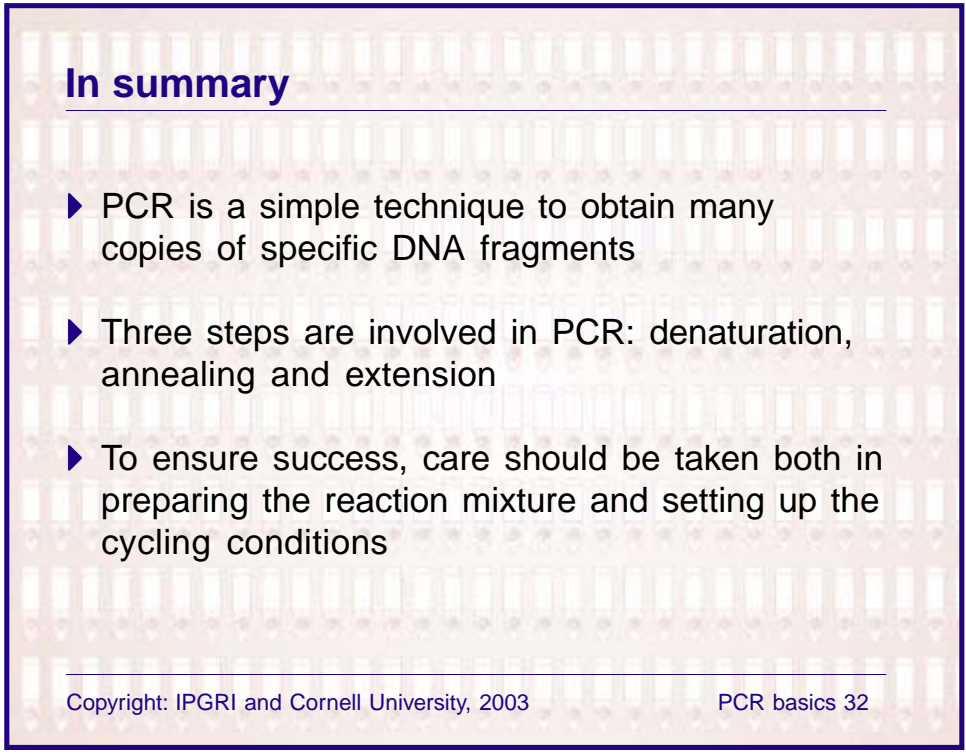
[picture p32: figure]
In summary; copies of specific DNA fragments; annealing and extension; cycling conditions

32

Copyright: IPGRI and Cornell University, 2003 | PCR basics 32

## ! PCR is a simple technique to obtain many

! Three steps are involved in PCR: denaturation,

## ! To ensure success, care should be taken both in preparing the reaction mixture and setting up the

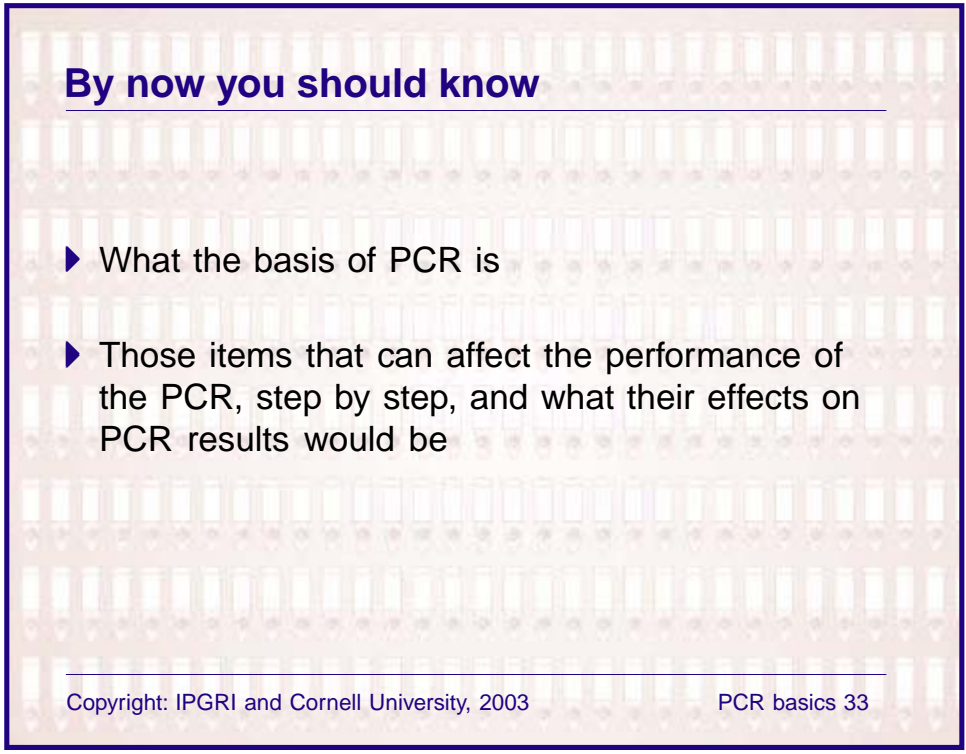
[picture p33: figure]
By now you should know; ! What the basis of PCR is; PCR results would be

33

Copyright: IPGRI and Cornell University, 2003 | PCR basics 33

## ! Those items that can affect the performance of the PCR, step by step, and what their effects on

## Basic references

Erlich, H.A. 1989. PCR technology: principles and applications for DNA amplifications. Stockton Press, NY.

Erlich, H.A. and N. Arnheim. 1992. Genetic analysis using the polymerase chain reaction. Ann. Rev. Genet. 26:479-506.

Griffiths, A.J.F., J.H. Miller, D.T. Suzuki, R.C. Lewontin and W.M. Gelbart. 1996. An introduction to genetic analysis (6th edn.). W.H. Freeman and Co., NY.

Newton, C.R. and A. Graham. 1994. PCR, part 1: Basic principles and methods. EngBios Scientific Publishers, Oxford.

Saiki, R.K., D.H. Gelfand, S. Stoffel, S.J. Scharf, R. Higuchi, G.T. Horn, K.B. Mullis and H.A. Erlich. 1988. Primer-directed enzymatic amplification of DNA with a thermostable DNA polymerase. Science 239:487-491.

34

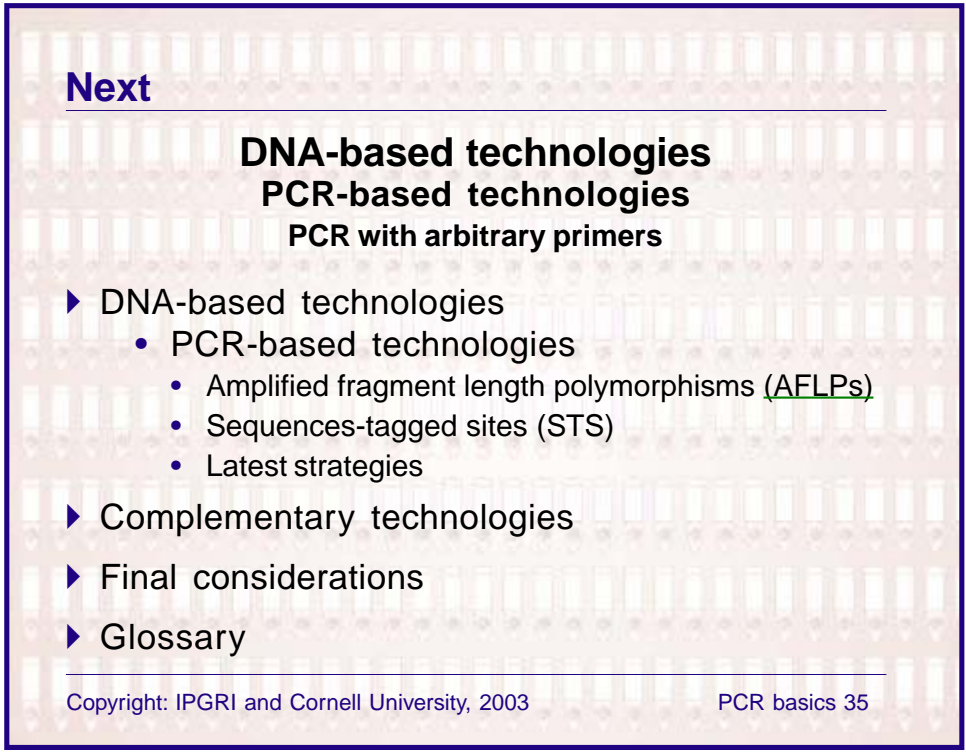
[picture p34: figure]
Next; DNA-based technologies PCR-based technologies PCR with arbitrary primers; ! DNA-based technologies • PCR-based technologies; • Sequences-tagged sites (STS) • Latest strategies ! Complementary technologies ! Final considerations ! Glossary

35

Copyright: IPGRI and Cornell University, 2003 | PCR basics 35

### - Amplified fragment length polymorphisms (AFLPs)
