ND-HowardGroup/pcr/cad/mainboard/ND_PCR_board_edited.pdf

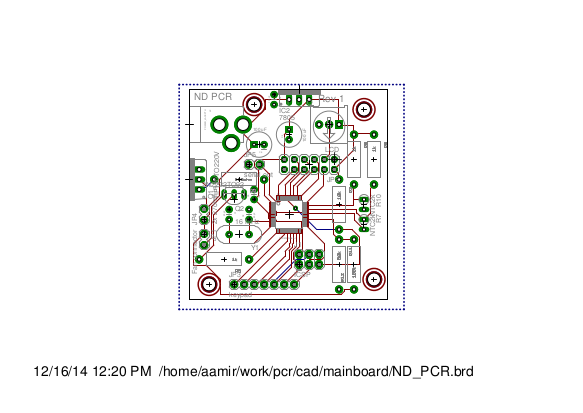
[picture p35: page 1]
