ND-HowardGroup/pcr/logFiles/log_realRun_22Apr2015.pdf

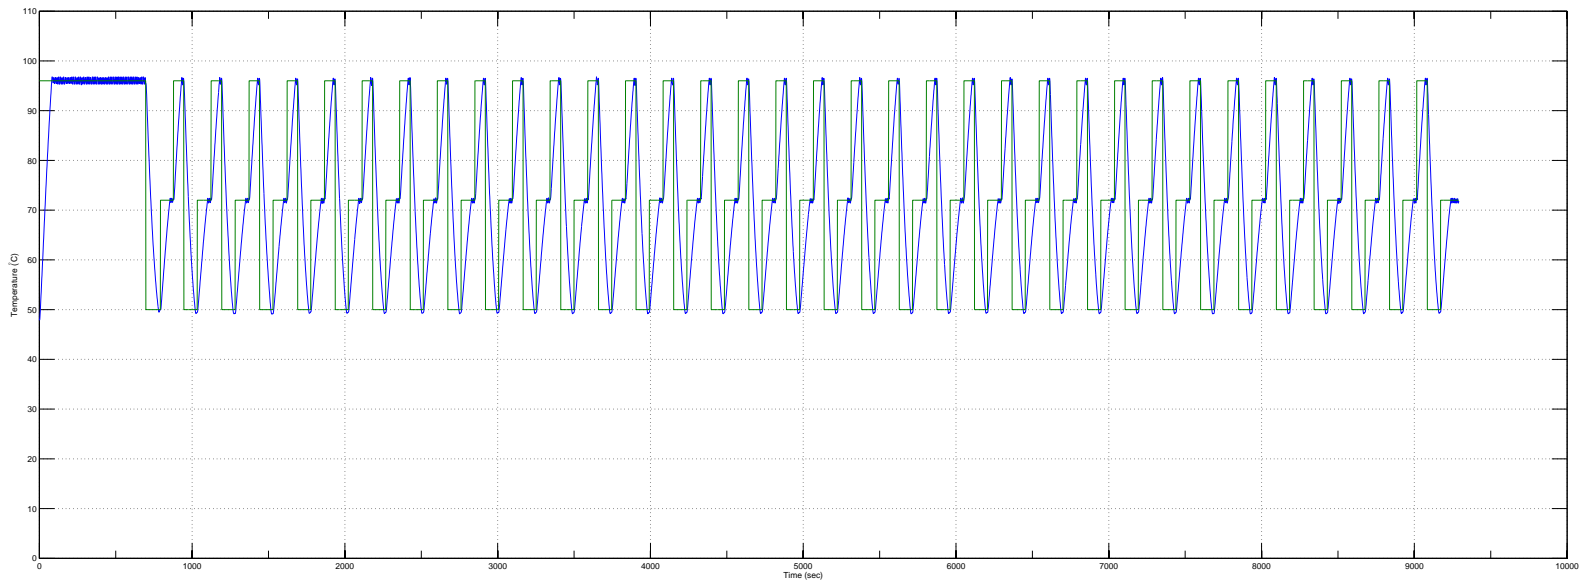
[picture p36: page 1]
Time (sec); Temperature (
