ND-HowardGroup/pcr/cad/daughterBoard/FT232-Breakout-v1_board.pdf

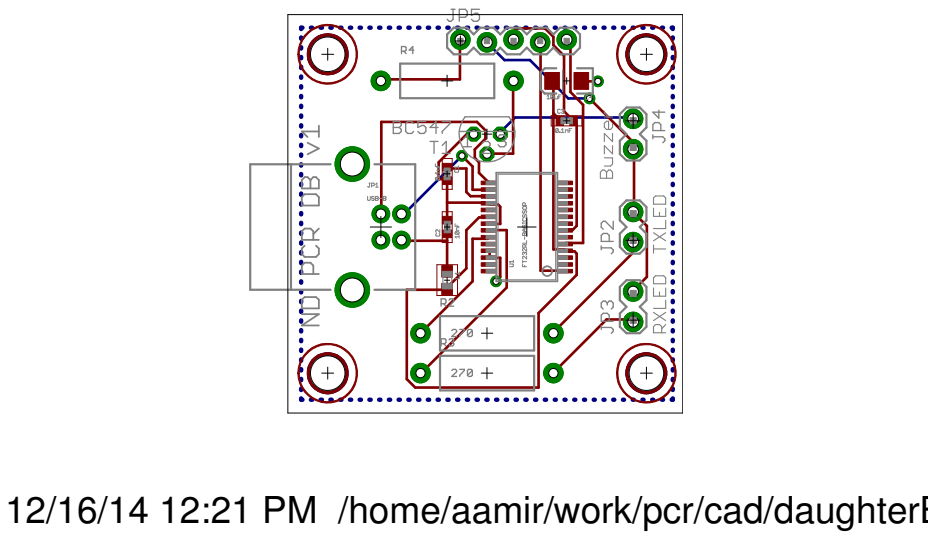
[picture p37: page 1]

12/16/14 12:21 PM /home/aamir/work/pcr/cad/daughterB
