ND-HowardGroup/pcr/cad/daughterBoard/FT232-Breakout-v1_sch.pdf

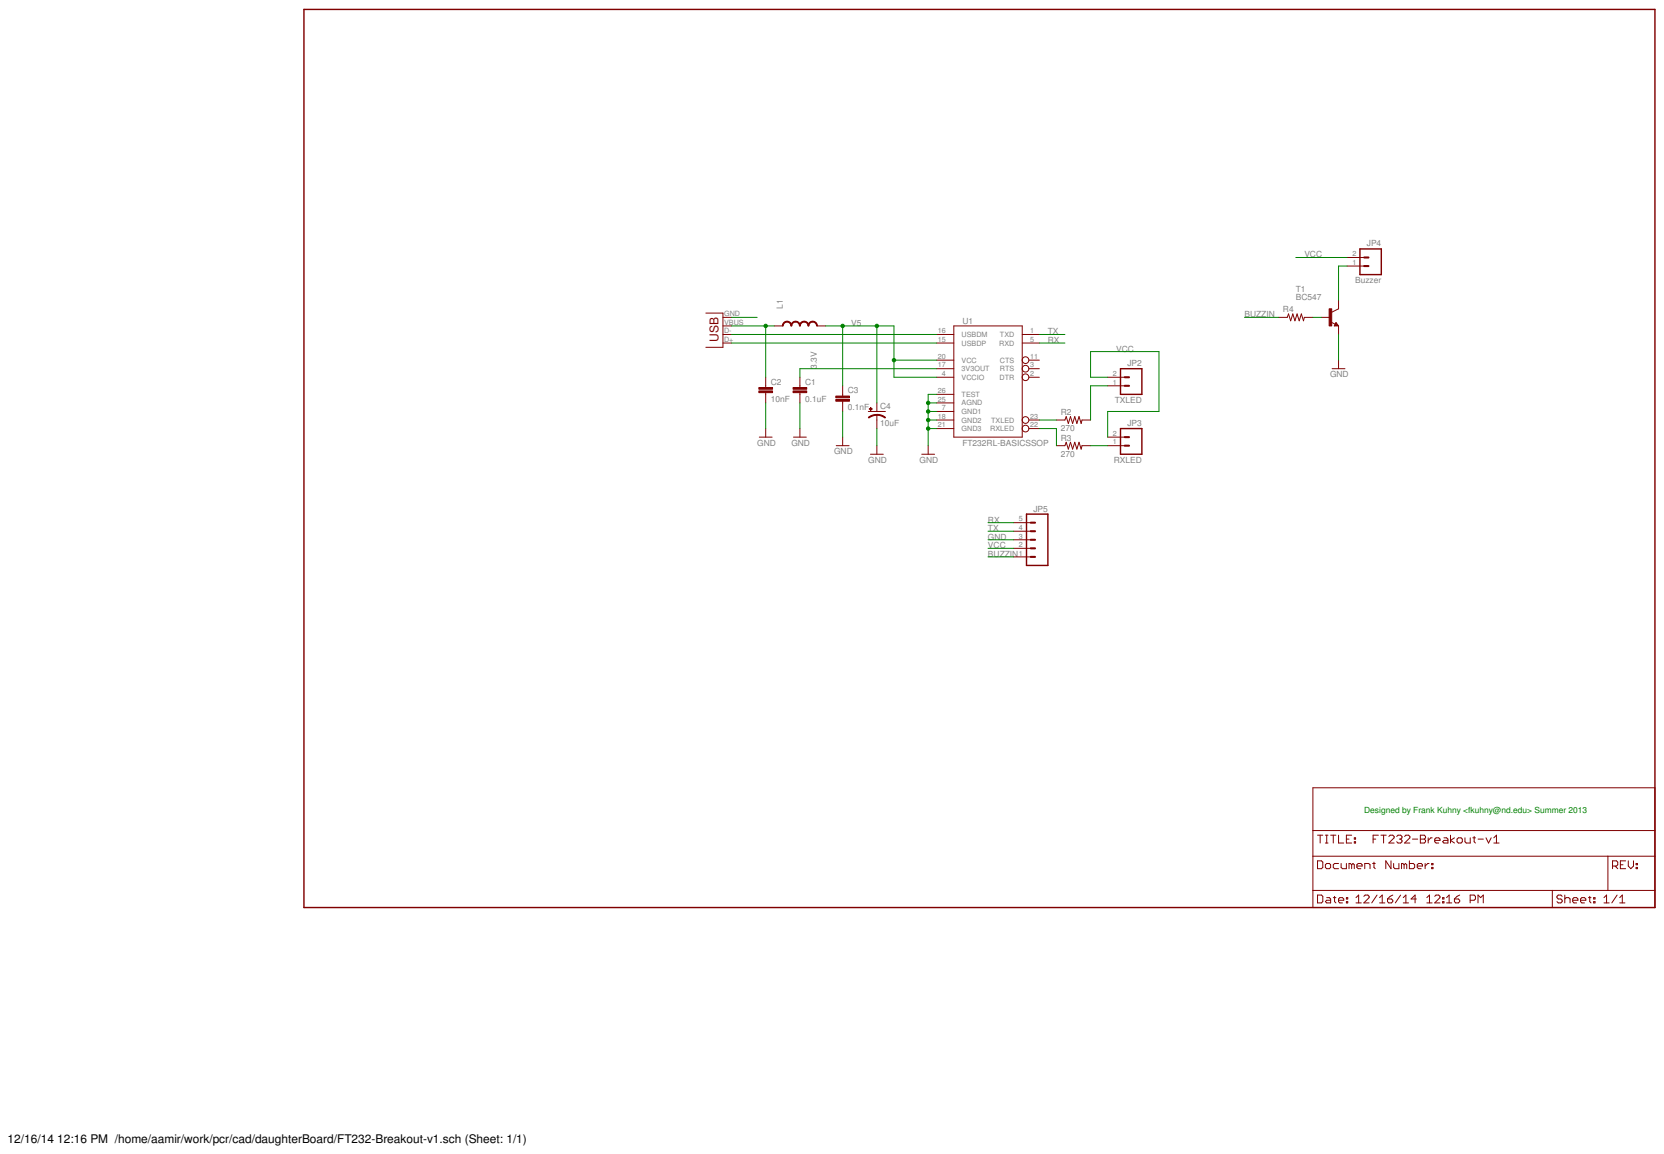
[picture p38: page 1]

Designed by Frank Kuhny <fkuhny@nd.edu> Summer 2013

12/16/14 12:16 PM /home/aamir/work/pcr/cad/daughterBoard/FT232-Breakout-v1.sch (Sheet: 1/1)
