ND-HowardGroup/pcr/cad/mainboard/ND_PCR_board.pdf

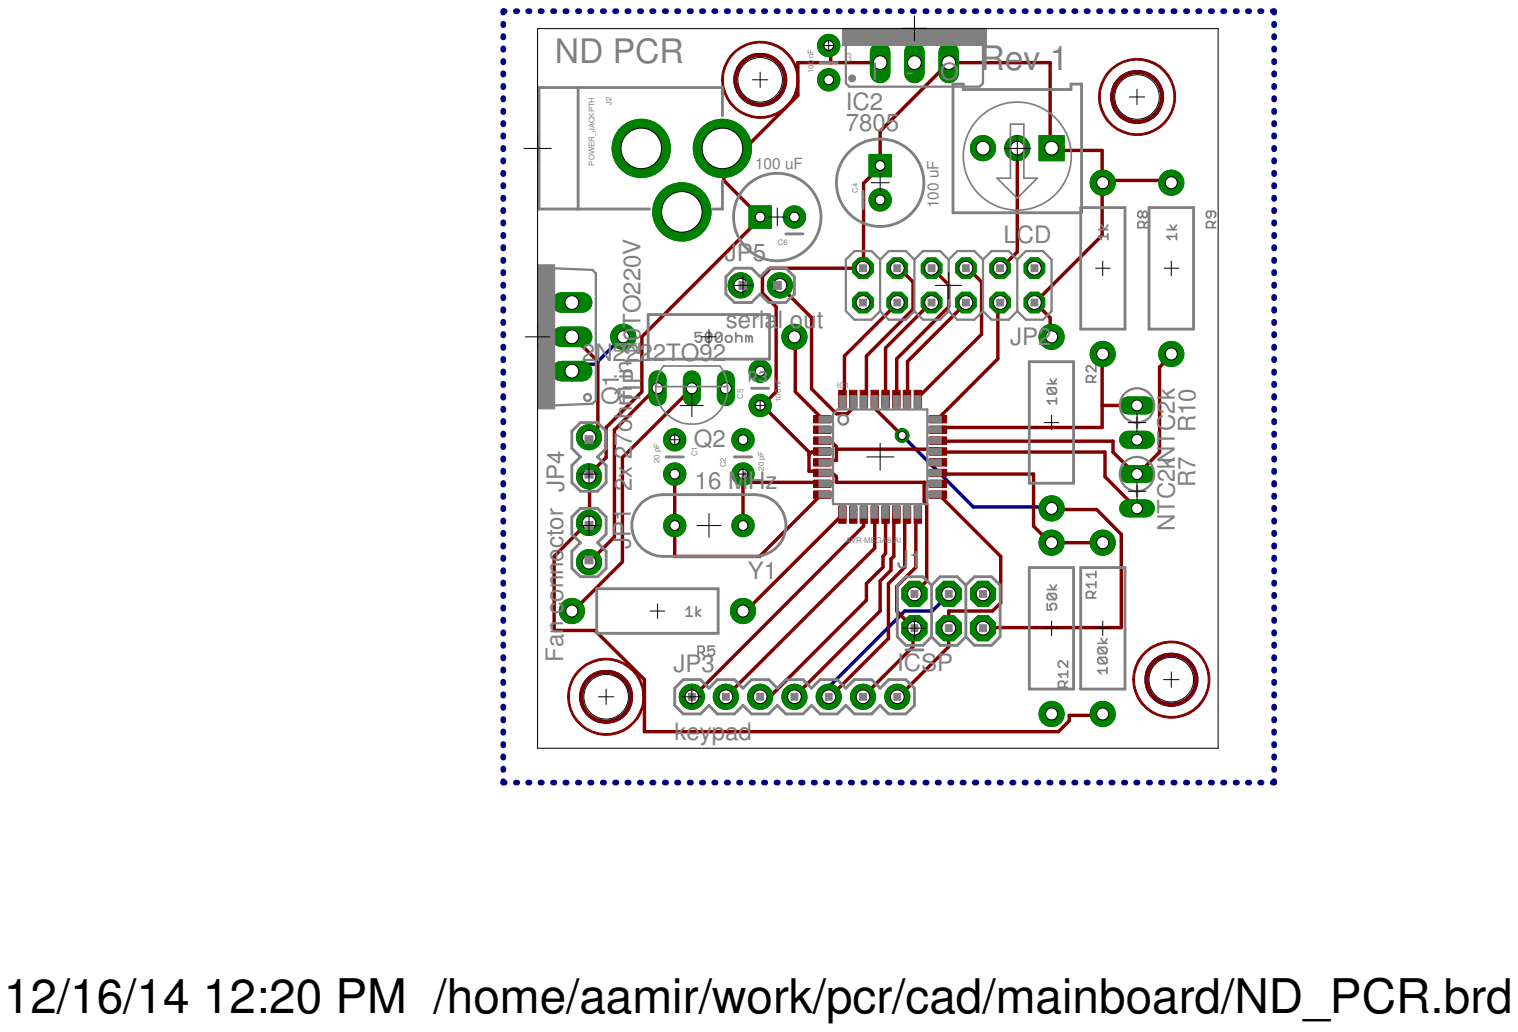
[picture p39: page 1]

12/16/14 12:20 PM /home/aamir/work/pcr/cad/mainboard/ND_PCR.brd
