ND-HowardGroup/pcr/cad/mainboard/ND_PCR_sch.pdf

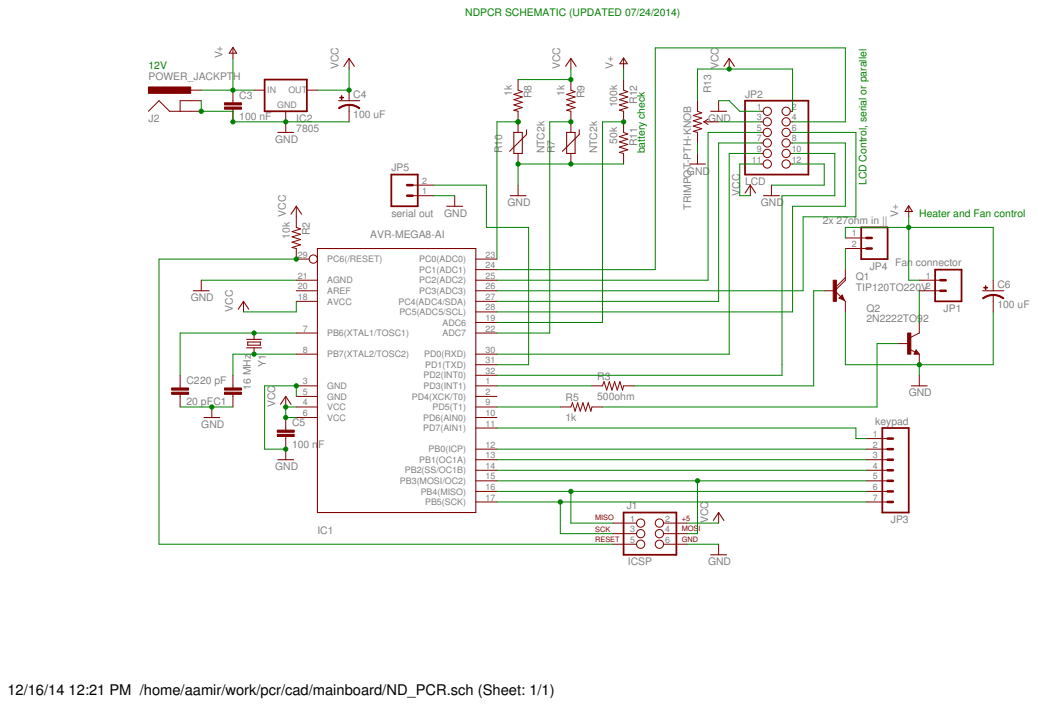
[picture p40: page 1]

LCD Control, serial or parallel Heater and Fan control

TRIMPOT-PTH-KNOB GND

12/16/14 12:21 PM /home/aamir/work/pcr/cad/mainboard/ND_PCR.sch (Sheet: 1/1)
