ND-HowardGroup/pcr/cad/mainboard/ND_PCR.brd

## EAGLE design cad/mainboard/ND_PCR.brd (2014-07-31)

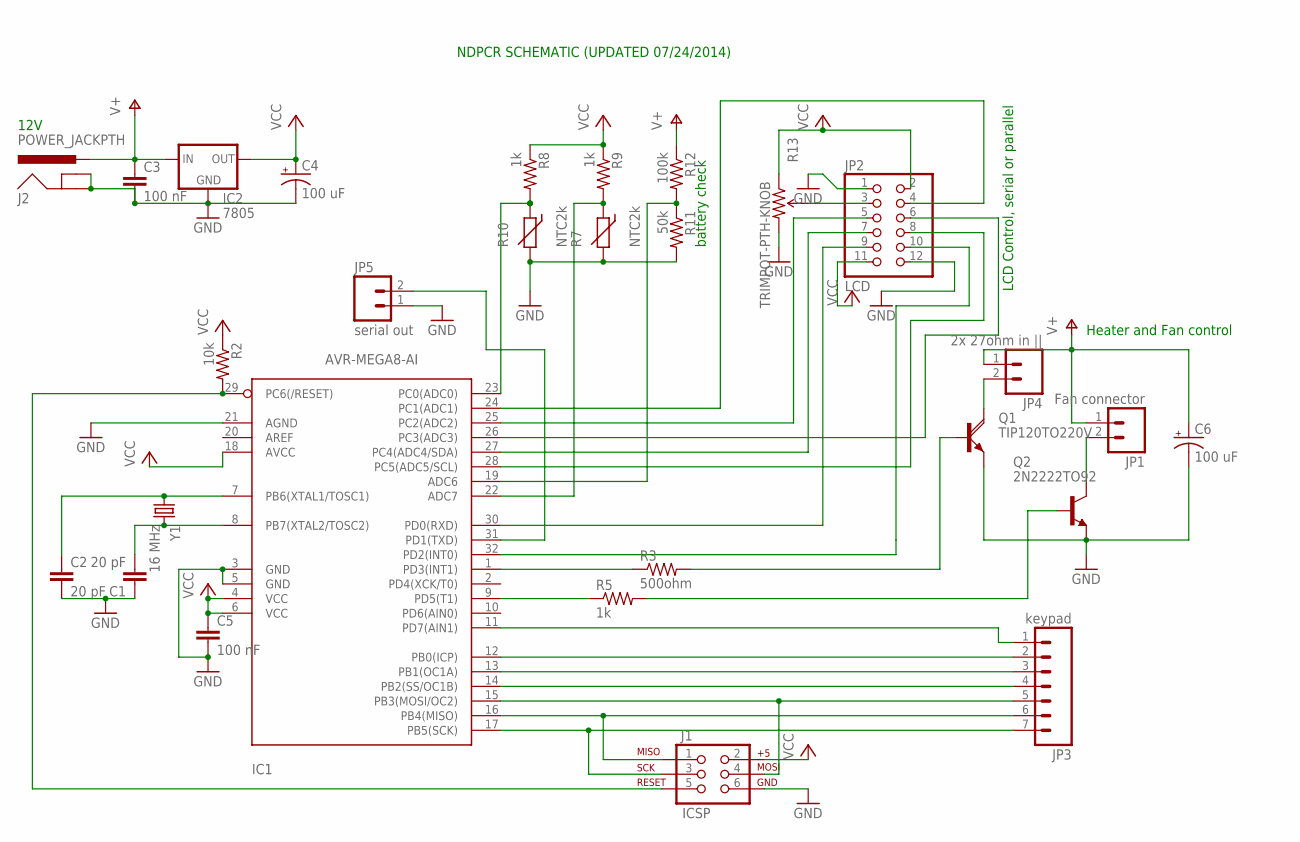
[picture p41: schematic ND_PCR.sch]

Parts:
C1, C2: 20 pF; CAP-PTH-SMALL
C3, C5: 100 nF; CAP-PTH-SMALL
C4, C6: 100 uF; CPOL-RADIAL-100UF-25V
IC1: AVR-MEGA8-AI; TQFP32-08
IC2: 7805; 78XXS
J1: ICSP; 2X3
J2: POWER_JACKPTH; POWER_JACK_PTH
JP1: Fan connector; 1X02_LOCK
JP2: LCD; 2X06
JP3: keypad; 1X07
JP4: 2x 27ohm in ||; 1X02_LOCK
JP5: serial out; 1X02_LOCK
Q1: TIP120TO220V; TO220AV
Q2: 2N2222TO92; TO92-EBC
R2: 10k; AXIAL-0.5
R3: 500ohm; AXIAL-0.5
R5, R8, R9: 1k; AXIAL-0.5
R7, R10: NTC2k; RS-2,5
R11: 50k; AXIAL-0.5
R12: 100k; AXIAL-0.5
R13: TRIMPOT-PTH-KNOB; 3386U
Y1: 16 MHz; HC49US

Connections:
GND: C1.1, C2.2, C3.2, C4.2 (-), C5.2, C6.2 (-), IC1.3 (GND), IC1.5 (GND), IC1.21 (AGND), IC2.GND, J1.6, J2.GND, J2.GNDBREAK, JP2.1, JP2.12, JP5.1, Q1.E, Q2.C (E), R7.2, R10.2, R11.P$2 (2), R13.3 (CW)
unnamed: C2.1, IC1.7 (PB6(XTAL1/TOSC1)), Y1.1
unnamed: C1.2, IC1.8 (PB7(XTAL2/TOSC2)), Y1.2
unnamed: IC1.23 (PC0(ADC0)), R8.P$2 (2), R10.1
unnamed: IC1.15 (PB3(MOSI/OC2)), J1.4, JP3.5
unnamed: JP4.2, Q1.C
unnamed: IC1.29 (PC6(/RESET)), J1.5, R2.P$2 (2)
unnamed: IC1.16 (PB4(MISO)), J1.1, JP3.6
unnamed: IC1.17 (PB5(SCK)), J1.3, JP3.7
unnamed: IC1.24 (PC1(ADC1)), JP2.4
unnamed: IC1.1 (PD3(INT1)), R3.P$1 (1)
unnamed: Q1.B, R3.P$2 (2)
unnamed: IC1.31 (PD1(TXD)), JP5.2
unnamed: IC1.22 (ADC7), R7.1, R9.P$2 (2)
unnamed: IC1.9 (PD5(T1)), R5.P$1 (1)
unnamed: JP1.2, Q2.E (C)
unnamed: IC1.26 (PC3(ADC3)), JP2.6
unnamed: Q2.B, R5.P$2 (2)
unnamed: IC1.19 (ADC6), R11.P$1 (1), R12.P$2 (2)
unnamed: JP2.3, R13.2 (WIPER)
unnamed: IC1.25 (PC2(ADC2)), JP2.5
unnamed: IC1.28 (PC5(ADC5/SCL)), JP2.8
unnamed: IC1.27 (PC4(ADC4/SDA)), JP2.7
unnamed: IC1.30 (PD0(RXD)), JP2.9
unnamed: IC1.32 (PD2(INT0)), JP2.10
unnamed: IC1.11 (PD7(AIN1)), JP3.1
unnamed: IC1.12 (PB0(ICP)), JP3.2
unnamed: IC1.13 (PB1(OC1A)), JP3.3
unnamed: IC1.14 (PB2(SS/OC1B)), JP3.4
V+: C3.1, C6.1 (+), IC2.IN, J2.PWR, JP1.1, JP4.1, R12.P$1 (1)
VCC: C4.1 (+), C5.1, IC1.4 (VCC), IC1.6 (VCC), IC1.18 (AVCC), IC2.OUT, J1.2, JP2.2, JP2.11, R2.P$1 (1), R8.P$1 (1), R9.P$1 (1), R13.1 (CCW)

Notes on the sheet:
battery check
12V
LCD Control, serial or parallel
Heater and Fan control
NDPCR SCHEMATIC (UPDATED 07/24/2014)

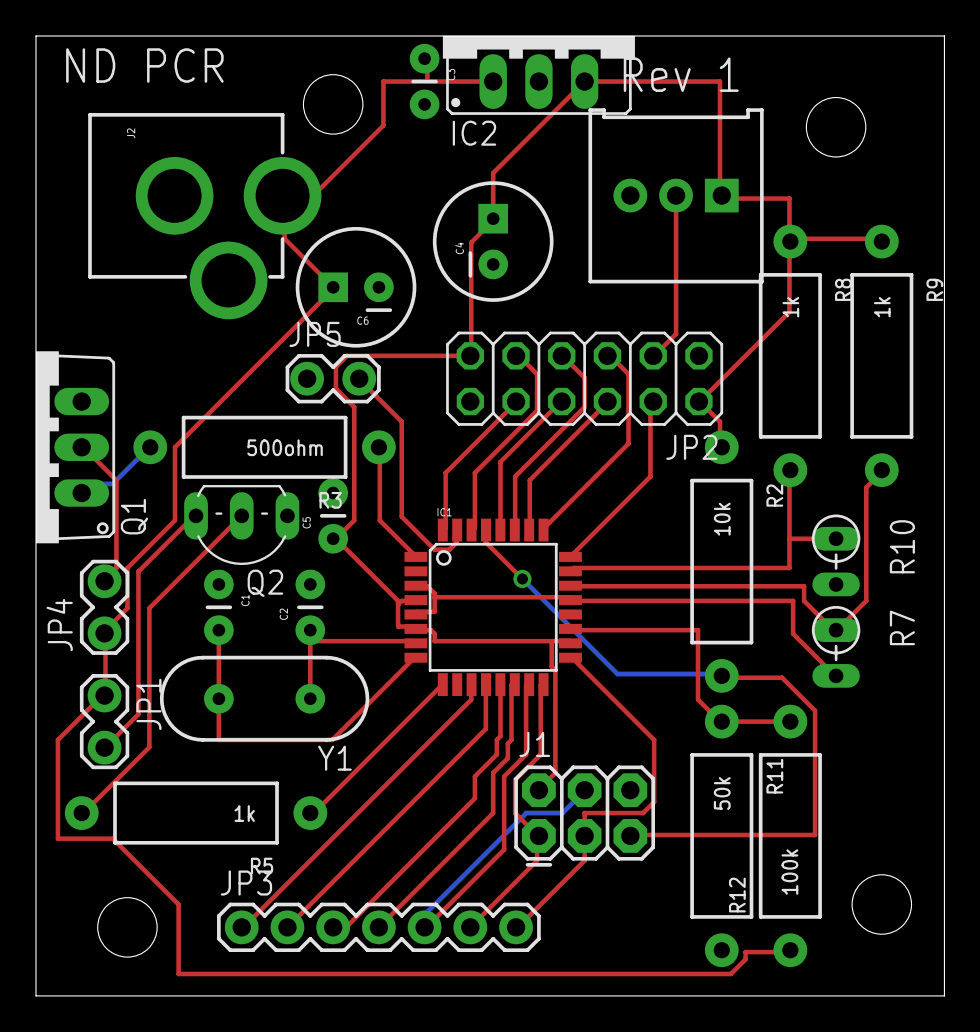
[picture p42: board ND_PCR.brd from above]

Board: 2 copper layers, 50.5 x 53.3 mm, 32 parts (0 on the bottom side), 31 nets.

Other parts of the board:
U$1, U$2, U$3, U$5: STAND-OFF
