ND-HowardGroup/pcr/cad/daughterBoard/FT232-Breakout-v1.brd

## EAGLE design cad/daughterBoard/FT232-Breakout-v1.brd (2013-10-16)

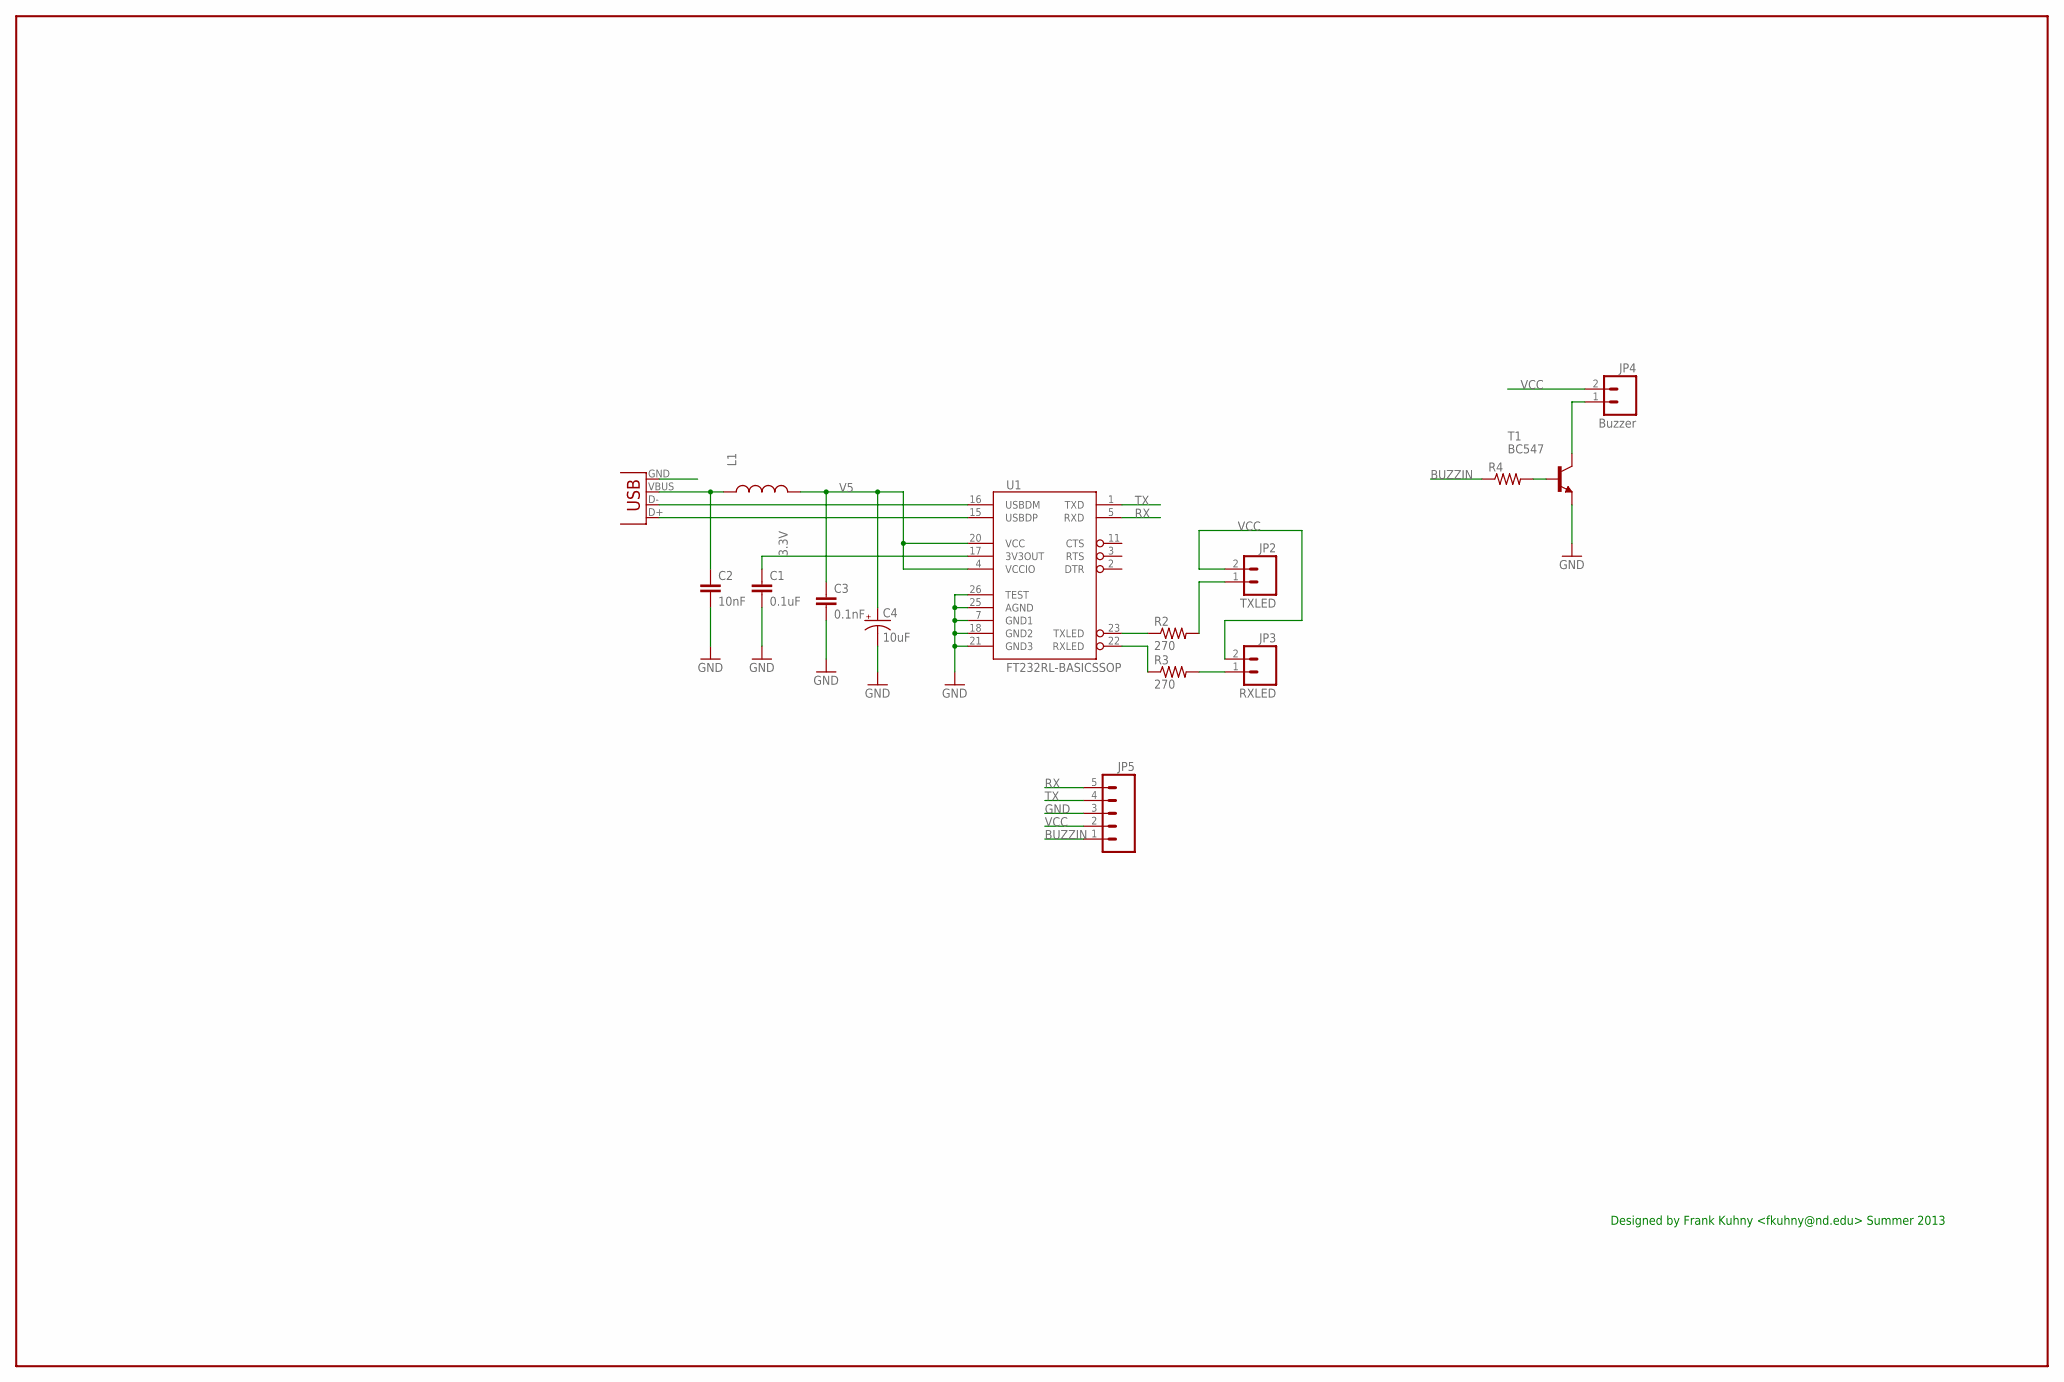
[picture p43: schematic FT232-Breakout-v1.sch]

Parts:
C1: 0.1uF; 0402-CAP
C2: 10nF; 0402-CAP
C3: 0.1nF; 0402-CAP
C4: 10uF; EIA3216
JP1: USB-B; USB-B-PTH
JP2: TXLED; 1X02_LOCK
JP3: RXLED; 1X02_LOCK
JP4: Buzzer; 1X02_LOCK
JP5: M05LOCK; 1X05_LOCK
L1: INDUCTOR0603; 0603
R2, R3: 270; AXIAL-0.5
R4: RESISTORPTH-1/2W; AXIAL-0.5
T1: BC547; TO92
U1: FT232RL-BASICSSOP; SSOP28DB

Connections:
3.3V: C1.1, U1.17 (3V3OUT)
BUZZIN: JP5.1, R4.P$1 (1)
GND: C1.2, C2.2, C3.2, C4.C (-), JP1.GND, JP5.3, T1.1 (E), U1.7 (GND1), U1.18 (GND2), U1.21 (GND3), U1.25 (AGND), U1.26 (TEST)
unnamed: C2.1, JP1.VBUS, L1.1
unnamed: R4.P$2 (2), T1.2 (B)
unnamed: JP3.1, R3.P$2 (2)
unnamed: JP1.D-, U1.16 (USBDM)
unnamed: JP1.D+, U1.15 (USBDP)
unnamed: JP4.1, T1.3 (C)
unnamed: R3.P$1 (1), U1.22 (RXLED)
unnamed: R2.P$1 (1), U1.23 (TXLED)
unnamed: JP2.1, R2.P$2 (2)
RX: JP5.5, U1.5 (RXD)
TX: JP5.4, U1.1 (TXD)
V5: C3.1, C4.A (+), L1.2, U1.4 (VCCIO), U1.20 (VCC)
VCC: JP2.2, JP3.2, JP4.2, JP5.2

Notes on the sheet:
Designed by Frank Kuhny <fkuhny@nd.edu> Summer 2013

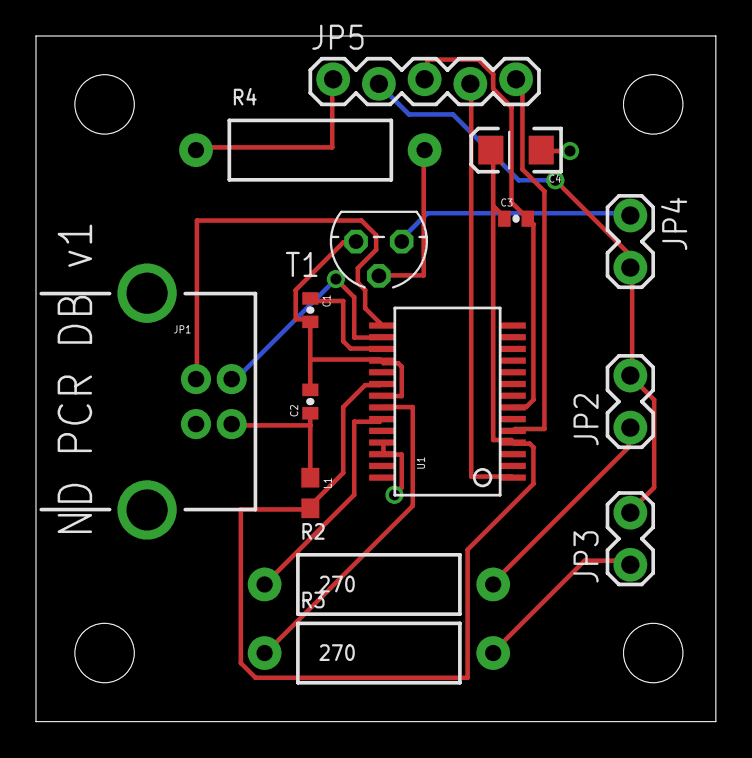
[picture p44: board FT232-Breakout-v1.brd from above]

Board: 2 copper layers, 37.8 x 38.1 mm, 19 parts (0 on the bottom side), 16 nets.

Other parts of the board:
U$1, U$2, U$3, U$4: STAND-OFF
