ND-HowardGroup/pcr/(commit log)

2012-06-14 Added CAD files for the case.
2012-07-18 added eagle schematics, cleaned up file names, moved cad/ to src/cad
    [ND_PCR.brd, ND_PCR.sch]
2012-07-20 New PID settings
2012-07-23 corrected function readtemps() and changed the setting for the fan
    now, whenever output is < 10 the fan is turned on and the heater is
    turned off.
    [ND_PCR.ino]
2012-07-23 Returned old fan setting
    the one i tried turned out to lock itself in a low temperature
2012-07-27 replaced 78l05 with 7805 in ND_PRC.brd
    [ND_PCR.brd, ND_PCR.sch]
2012-09-17 added some labels
    [ND_PCR.sch]
2012-11-06 Revision 4.5
    Now with more PID controller for heating elements
2013-01-31 updated PCR schematic PDF
2013-03-06 Commit older versions and new version. New rev_7 includes full commenting, new PID tuning, better user interface, and stop buzzer. Still needs to include a buzzer pin and have code modified before bu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
    [pcr_rev_7.ino]
2013-03-06 Last commit removed everything, changing again. Sorry, I'm bad at Git.
    [ND_PCR.brd, ND_PCR.sch]
2013-03-07 Added all old code to old repository, currently working in repo 7.
2013-03-19 Changed alignment of text and headers. Fixed time remaining for the most part; it just adds a flat 7% to total time. Fixed display and some serial monitor display stuff. Added some more comments.
    [ND_PCR.ino]
2013-05-30 added in additional enclosure design
2013-05-31 Implemented buzzer and changed test program to be able to end.
    [ND_PCR.ino]
2013-10-16 add daughter board
    [FT232-Breakout-v1.brd, FT232-Breakout-v1.sch]
2013-10-16 modified daughter board for production
    [FT232-Breakout-v1.brd, FT232-Breakout-v1.sch]
2014-07-24 PCR code fixes
    Changed recipe (times and temperatures) to match MTWASP from openPCR
    Added +2 degrees to offset temperature differences from sensed
    temperature in well vs temperature read by thermistors
    Fix serial print - now includes cycle number
    Measured rise and fall time and included in calcRemainingTime()
    Changed fudgeFactor to smaller value since rise and fall time are now
    included
    [ND_PCR.ino]
2014-07-24 Eagle CAD fixes
    Changed 10k resistor attached to thermistor voltage divider network to
    1k (1k provides broadest range for ADC on atmega328p)
    [ND_PCR.brd]
2014-07-24 Main components datasheets
    Added datasheets and relevant application note for the main components
    on the NDPCR board for easy access
2014-12-16 Directory structure cleaned up and reorganized heavily. Bill of materials (BOM) generated through Eagle for both main and daughter boards. TODO lists added to src/ and doc/ folders. Deleted the USB_H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
    [FT232-Breakout-v1.brd, FT232-Breakout-v1.sch, FT232-Breakout-v1_BOM.csv, ND_PCR.brd, ND_PCR.sch, ND_PCR_BOM.csv]
2015-04-23 * Reorganized directory structure to build with 'ino' tool instead of Arduino IDE. * PCR code heavily modified and cleaned up. Keypad, buzzer, two fans, LCD display, and serial monitor is working. * 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
    [AutoTune_PCR.ino, ND_PCR.ino]
2015-04-23 ** ND-PCR v2 ready ** Reorganized directory structure to build with 'ino' tool instead of Arduino IDE. PCR code heavily modified and cleaned up. Keypad, buzzer, two fans, LCD display, and serial moni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
    [AutoTune_PCR.ino, ND_PCR.ino]
2015-04-29 Fixed the PCR recipes * Denaturation setpoint = 94 C * Final elongation time = 600 s
    [ND_PCR.ino]
